RobbeElsermans/GestureControl/README.md

# Gesture Controlling 

Gesture controlling with X-NUCLEO-53L3A2 DevKit.

Developed by Robbe Elsermans With ED&A.

Info over de code is te vinden [hier](https://robbeelsermans.github.io/GestureControl/#/).
