RobbeElsermans/GestureControl/Final Project/Code/README.md

In deze folder **Code Final** zal je het finale projecten terug vinden. Hierin hebben we 2 versies.

* V1 is (deels) gegenereerd door ST. en gebruikt de HAL Drivers.
* V2 is er een abstractie laag (experimenteel) toegevoegd bovenop de HAL Drivers.

Beide versies werken.

beide versies zijn te compileren in PlatformIO. Hiervoor verwijs ik u graag naar de [documentatie](https://robbeelsermans.github.io/GestureControl/#/).
