RobbeElsermans/GestureControl/docs/_sidebar.md

- [Gesture Control](README.md#gesture-control)
- [Inhoudsopgaven](README.md#inhoudsopgaven)
- [Inleiding](README.md#inleiding)
- [Project Definitie](README.md#project-definitie)
- [Gebruikte Software](README.md#gebruikte-software)
- [Gebruikte Hardware](README.md#gebruikte-hardware)
- [Opbouw Project](README.md#opbouw-project)
  - [PinOut](README.md#pinout)
    - [Pin description](README.md#pin-description)
  - [genereer code](README.md#genereer-code)
  - [Importeer API VL53LXC](README.md#importeer-api-vl53lxc)
  - [importeren include & src bestanden](README.md#importeren-include--src-bestanden)
  - [Importeer Andere Bestanden](README.md#importeer-andere-bestanden)
  - [Installeer Platform & Board](README.md#installeer-platform--board)
  - [configureer platformio.ini file](README.md#configureer-platformioini-file)
  - [main.h & .c](README.md#mainh--c)
  - [Overzicht Bestanden](#overzicht-bestanden)
  - [Build & Upload](README.md#build--upload)
- [Hardware Opbouw](README.md#hardware-opbouw)
- [LED Controller](README.md#led-controller)
- [Bevindingen & Upgrades](README.md#bevindingen--upgrades)
- [Onderzoek](README.md#onderzoek)
  - [Plaats Sensoren Development Kit](README.md#plaats-sensoren-development-kit)
  - [Snelheid Metingen Development Kit](README.md#snelheid-metingen-development-kit)
    - [Eén sensor](README.md#eén-sensor)
      - [BLOCKING_CONTINUOUS](README.md#blocking_continuous)
      - [ASYNC_CONTINUOUS](README.md#async_continuous)
    - [Vijf sensoren](README.md#vijf-sensoren)
      - [BLOCKING_CONTINUOUS](README.md#blocking_continuous-1)
      - [ASYNC_CONTINUOUS](README.md#async_continuous-1)
  - [Plaats Sensoren PCBV0.3](README.md#plaats-sensoren-pcbv03)
    - [Kruislings](README.md#kruislings)
    - [Piramide](README.md#piramide)
    - [Trap](README.md#trap)
  - [Snelheid Metingen PCBV0.3](README.md#snelheid-metingen-pcbv03)
  - [Coverglas](README.md#coverglas)
    - [plexiplaat](README.md#plexiplaat)
    - [glasplaat](README.md#glasplaat)
  - [Smudge Detection plexiplaat](README.md#smudge-detection-plexiplaat)
    - [Normale werking](README.md#normale-werking)
    - [VL53LX_SMUDGE_CORRECTION_SINGLE](README.md#vl53lx_smudge_correction_single)
    - [VL53LX_SMUDGE_CORRECTION_CONTINUOUS](README.md#vl53lx_smudge_correction_continuous)
  - [Smudge Detection glasplaat](README.md#smudge-detection-glasplaat)
  - [Trap in software verwerkt](README.md#trap-in-software-verwerkt)
    - [Op papier](README.md#op-papier)
    - [Met Data](README.md#met-data)
  - [Bevindingen](README.md#bevindingen)
