RobbeElsermans/GestureControl/docs/_coverpage.md

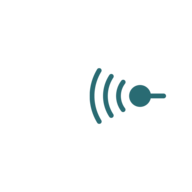
[picture p122: docs/FavoIcon/android-chrome-192x192.png]


# Gesture Control <small>1.0</small>

> A Gesture Controller interface for any application

- I<sup>2</sup>C supported
- Simple gestures
- Multiple enviroments

[GitHub](https://github.com/RobbeElsermans/GestureControl.git)
[Get Started](#Gesture-Control)

color
