RobbeElsermans/GestureControl/docs/foto's/Word foto editor.docx

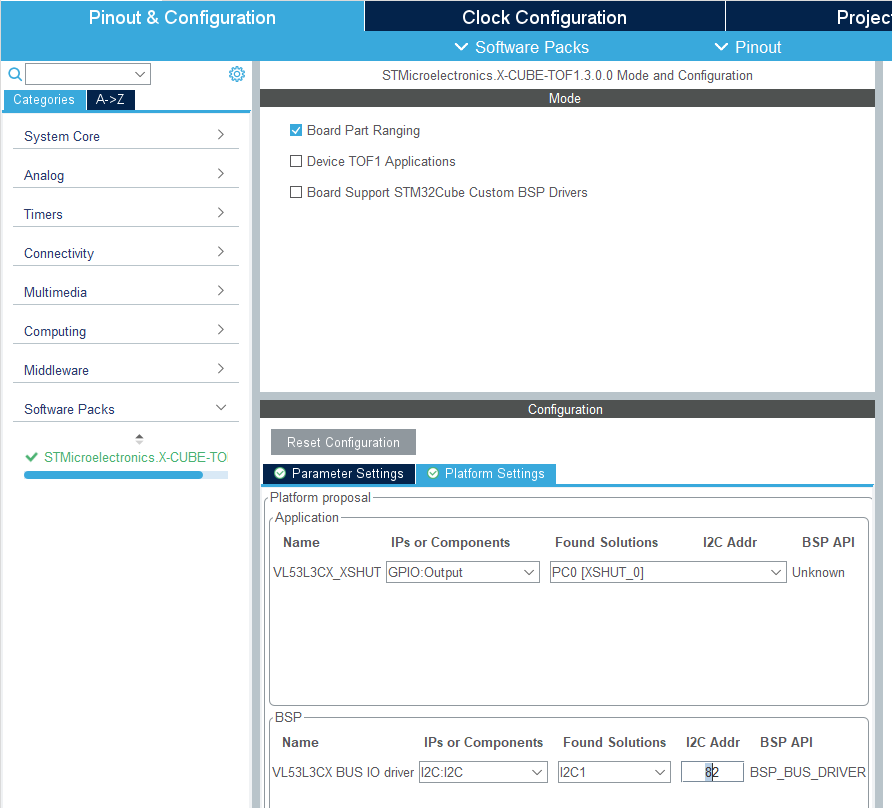
[picture p123: figure]
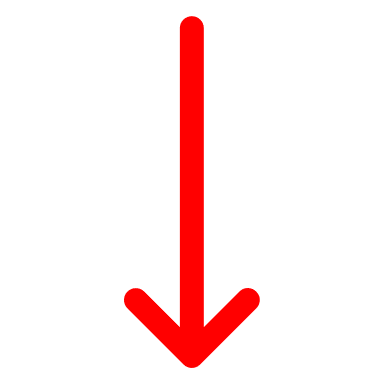
[picture p124: figure]
Pijl omhoog met effen opvulling

6

5

4

3

1

2

4
