RobbeElsermans/GestureControl/docs/foto's/DU_R_D_N_SNEL.png

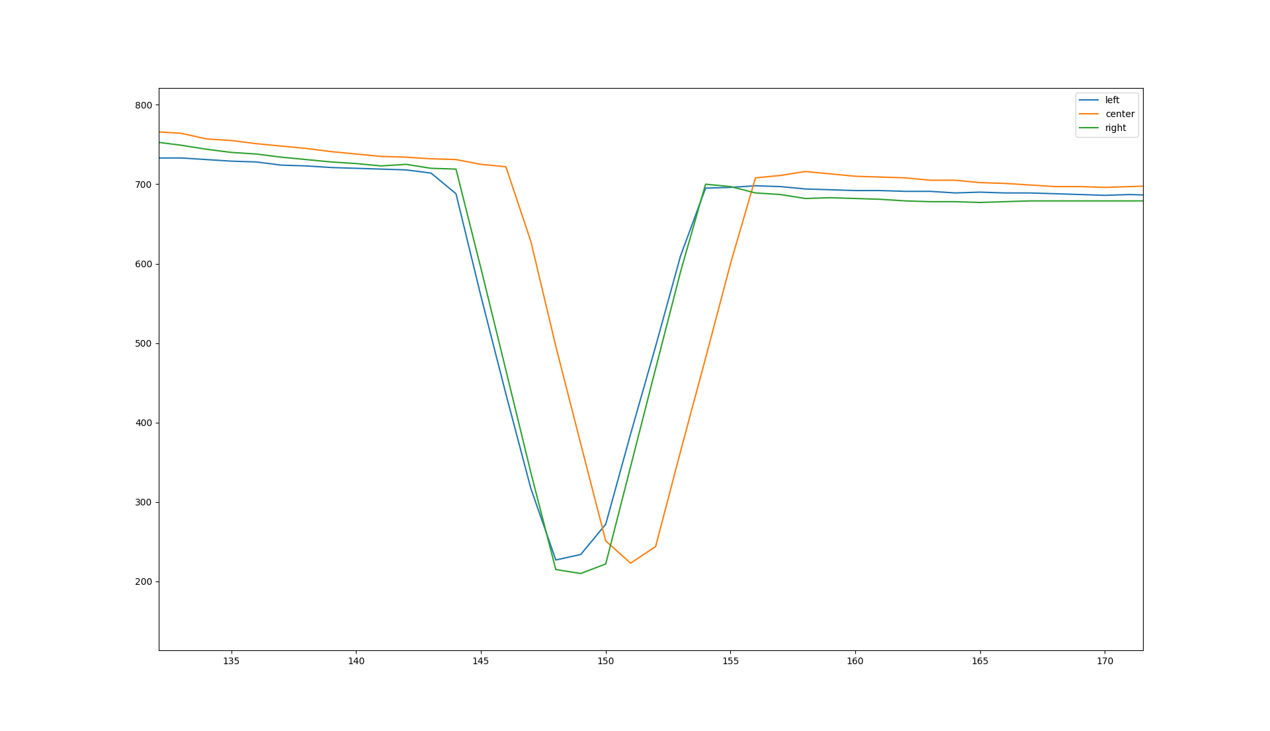
docs/foto's/DU_R_D_N_SNEL.png
