RobbeElsermans/GestureControl/docs/foto's/LR_R_D_N_SNEL.png

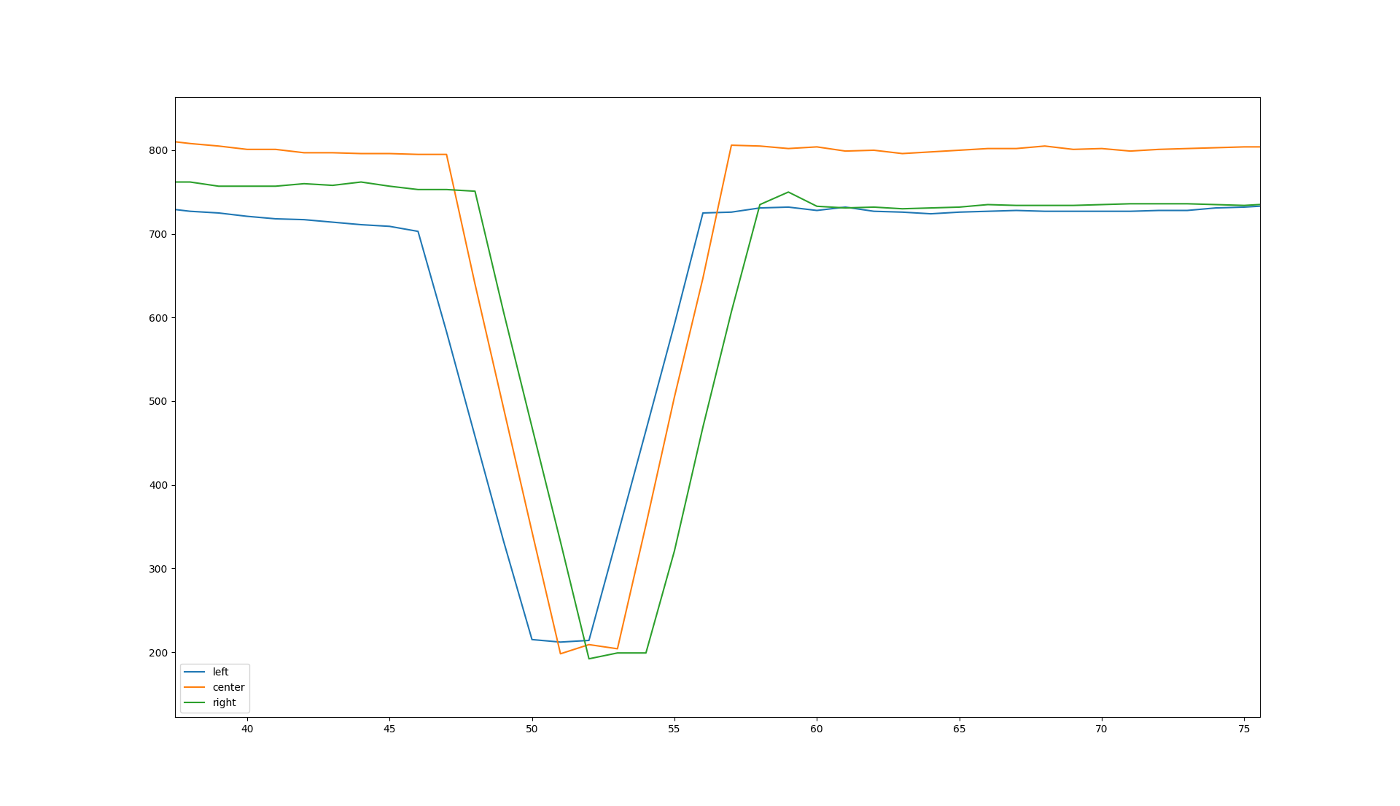
docs/foto's/LR_R_D_N_SNEL.png
