RobbeElsermans/GestureControl/docs/foto's/RL_R_D_N_SNEL.png

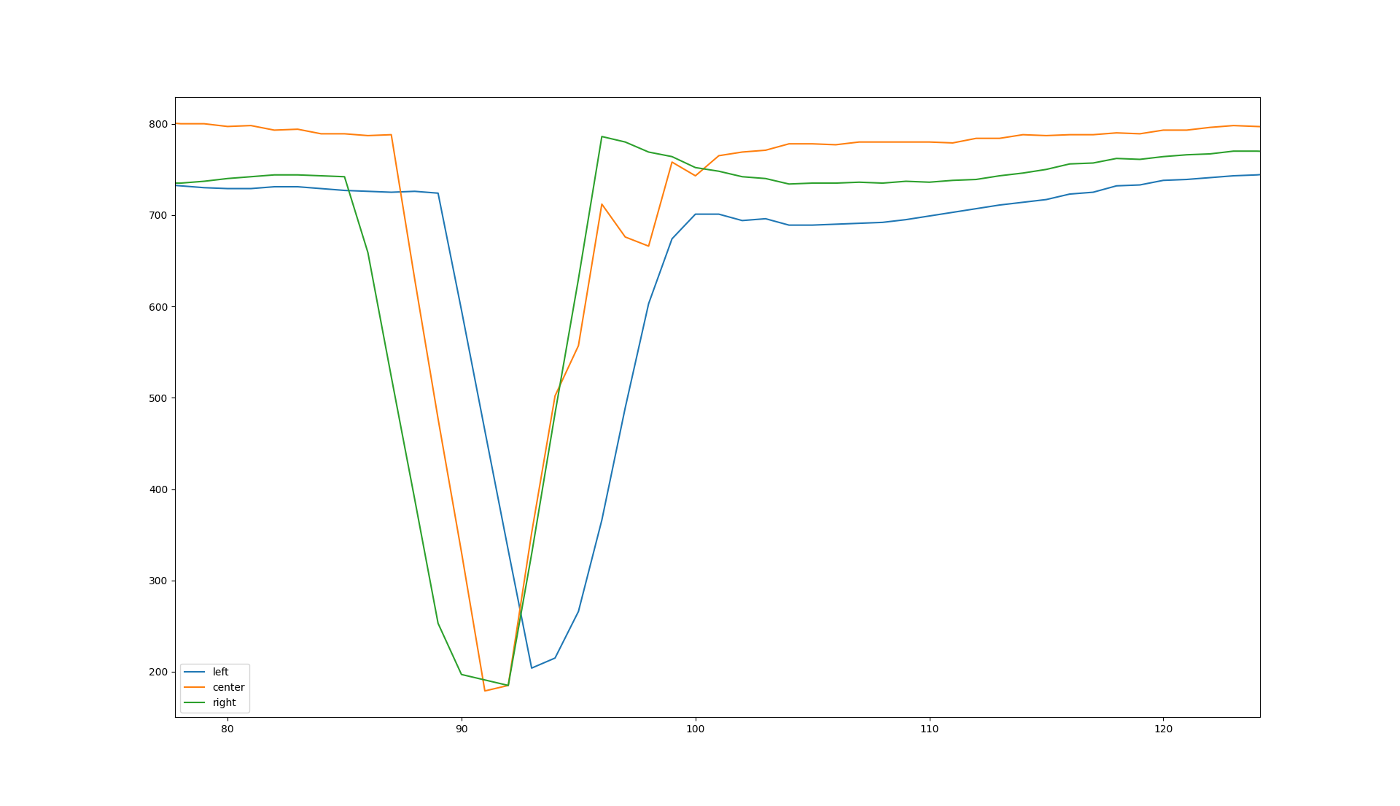
docs/foto's/RL_R_D_N_SNEL.png
