RobbeElsermans/GestureControl/docs/foto's/UD_R_D_N_SNEL.png

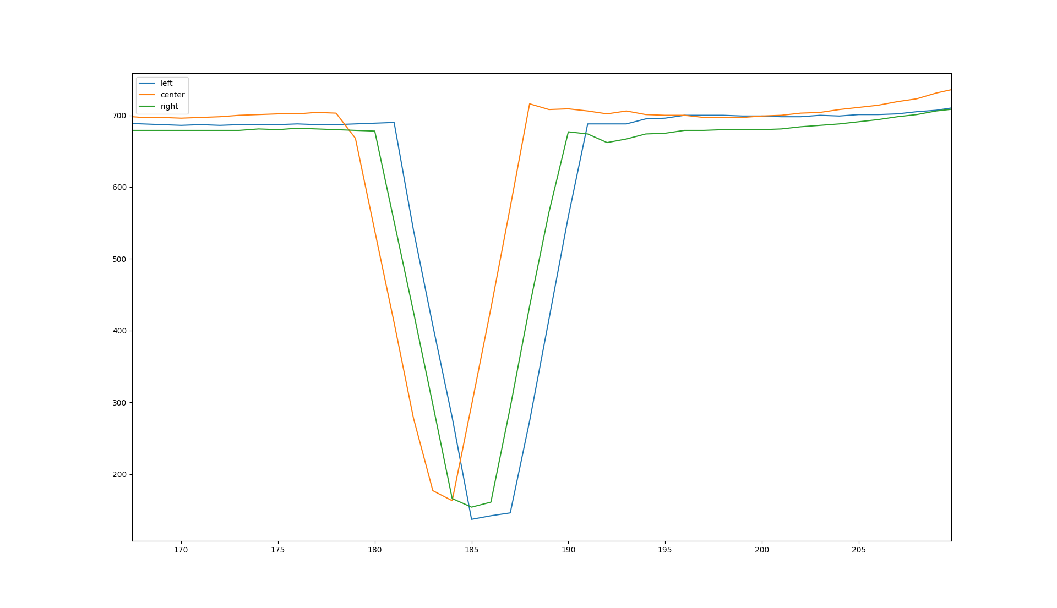
docs/foto's/UD_R_D_N_SNEL.png
