RobbeElsermans/GestureControl/docs/Hardware/PCB3D.png

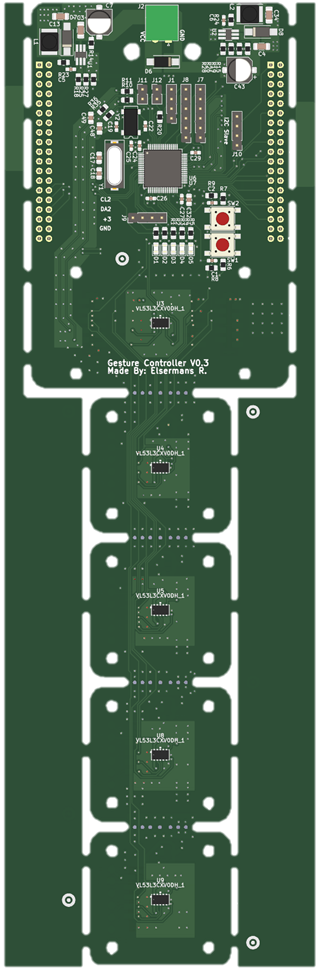
docs/Hardware/PCB3D.png
