RobbeElsermans/GestureControl/docs/Hardware/Schermafbeelding 2022-03-24 133611.jpg

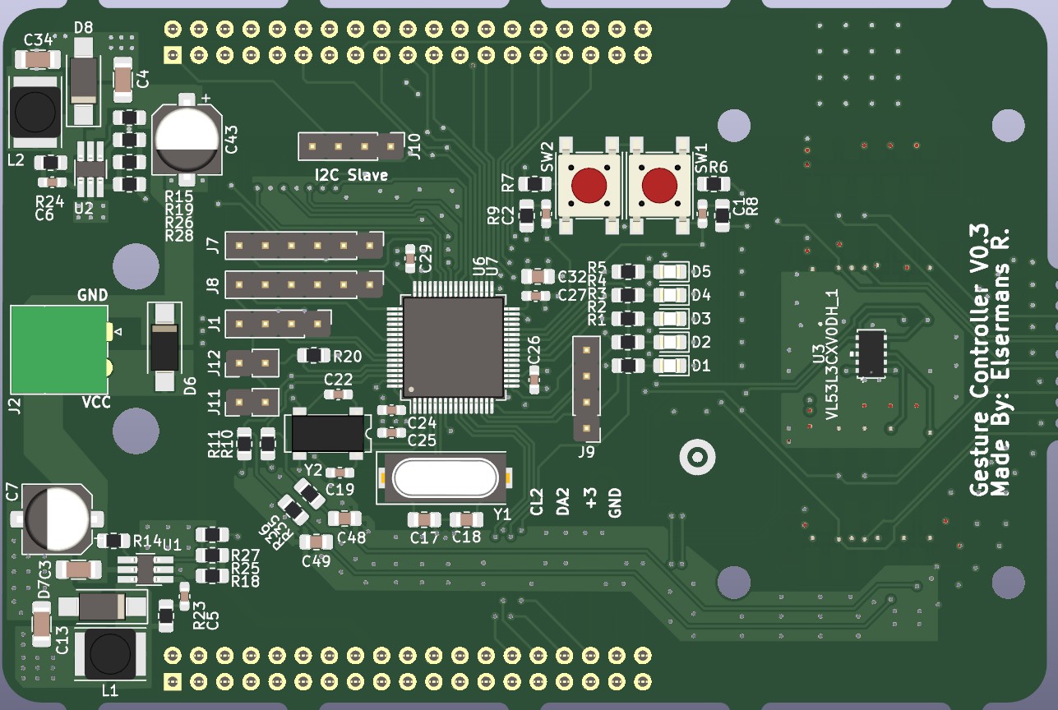
docs/Hardware/Schermafbeelding 2022-03-24 133611.jpg
