RobbeElsermans/GestureControl/Final Project/Code/Led Controller V2/plantuml/L1.png

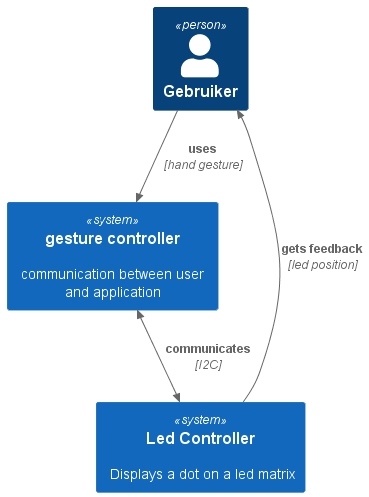
Final Project/Code/Led Controller V2/plantuml/L1.png
