RobbeElsermans/GestureControl/Final Project/Code/Led Controller V2/plantuml/L2.png

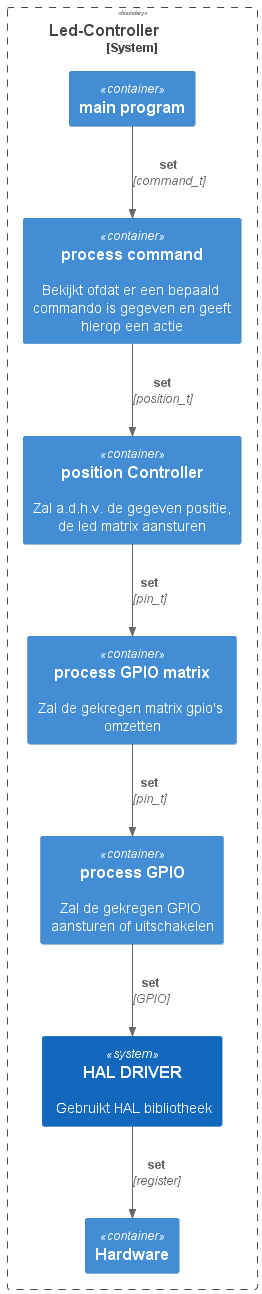
Final Project/Code/Led Controller V2/plantuml/L2.png
