RobbeElsermans/GestureControl/3D designs/breakoutboard/breakoutboard-main_holder.stl

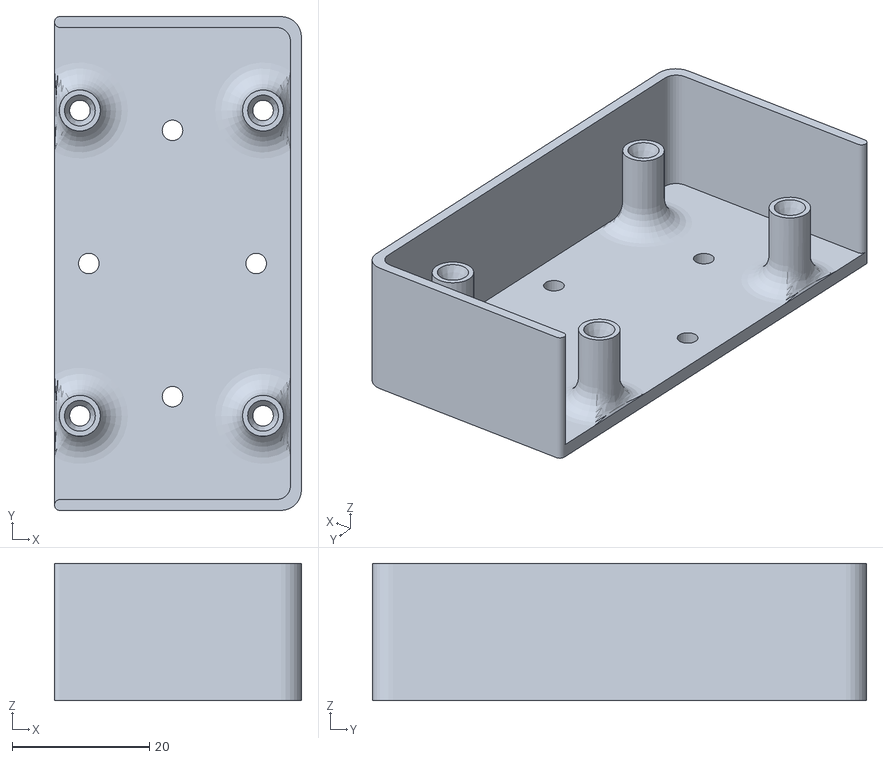
[picture p133: CAD file, 2022-03-29]
3D designs/breakoutboard/breakoutboard-main_holder.stl
36.0 x 72.0 x 20.0
