RobbeElsermans/GestureControl/3D designs/breakoutboard/PCBV0.3-Body.stl

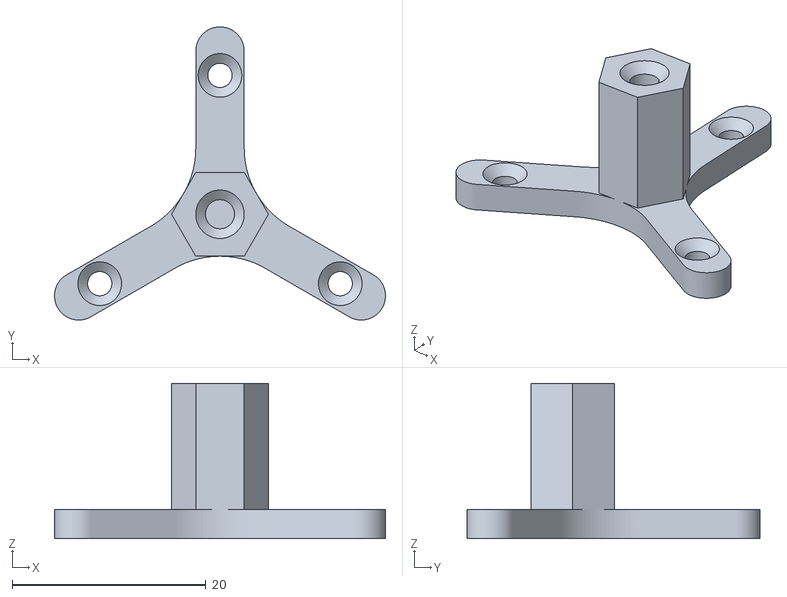
[picture p134: CAD file, 2022-04-15]
3D designs/breakoutboard/PCBV0.3-Body.stl
34.2 x 30.2 x 16.0
