RobbeElsermans/GestureControl/3D designs/Final opstelling/Gesture Controller-Body.3mf

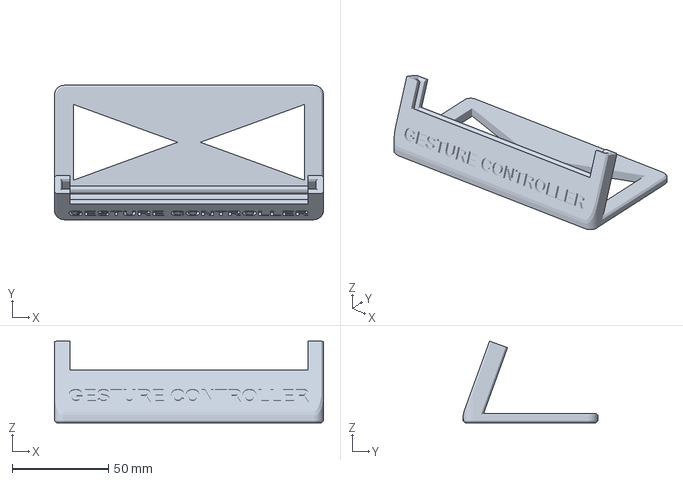
[picture p135: CAD file, 2022-05-14]
3D designs/Final opstelling/Gesture Controller-Body.3mf
140.0 x 70.0 x 42.6 mm
