RobbeElsermans/GestureControl/3D designs/Led Controller/nucleo striped.FCStd

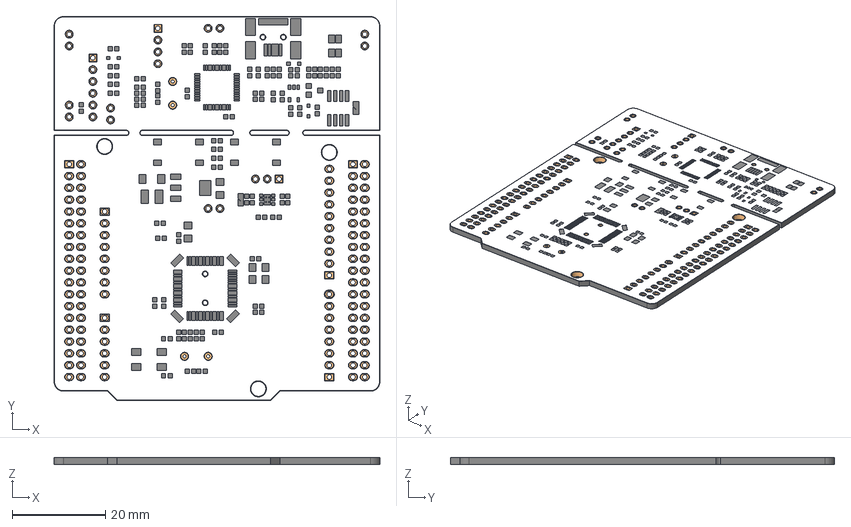
[picture p136: CAD file, 2022-05-14]
3D designs/Led Controller/nucleo striped.FCStd
70.0 x 82.5 x 1.58 mm
NUCLEO-F411RE_PCB_Varsaylan
NUCLEO-F411RE_PCB_HOLEs_Varsaylan
NUCLEO-F411RE_PCB_TOP_Solder_Varsaylan
NUCLEO-F411RE_PCB_BOTTOM_Pads_Varsaylan
NUCLEO-F411RE_PCB_BOTTOM_Solder_Varsaylan
