RobbeElsermans/GestureControl/3D designs/PCBV0.3/GlasPlates-Glasklever.step

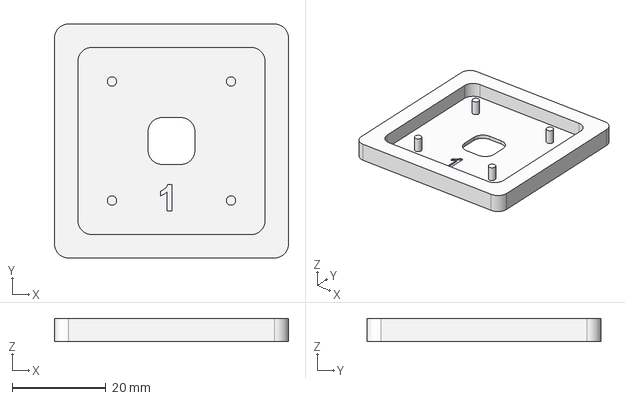
[picture p137: CAD file, 2022-05-10]
3D designs/PCBV0.3/GlasPlates-Glasklever.step
50.0 x 50.0 x 5.00 mm
