RobbeElsermans/GestureControl/Final Project/3D Design/Coverglas Gesture Controller/GlasPlates.FCStd

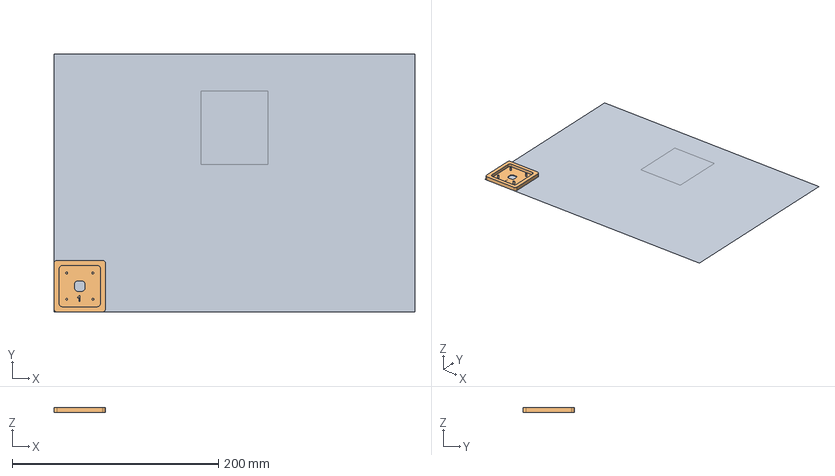
[picture p138: CAD file, 2022-05-24]
Final Project/3D Design/Coverglas Gesture Controller/GlasPlates.FCStd
350.0 x 250.0 x 5.00 mm
Block_SKETCH071
Glasklever
