RobbeElsermans/GestureControl/Final Project/3D Design/Stand Gesture Controller/Gesture Controller.FCStd

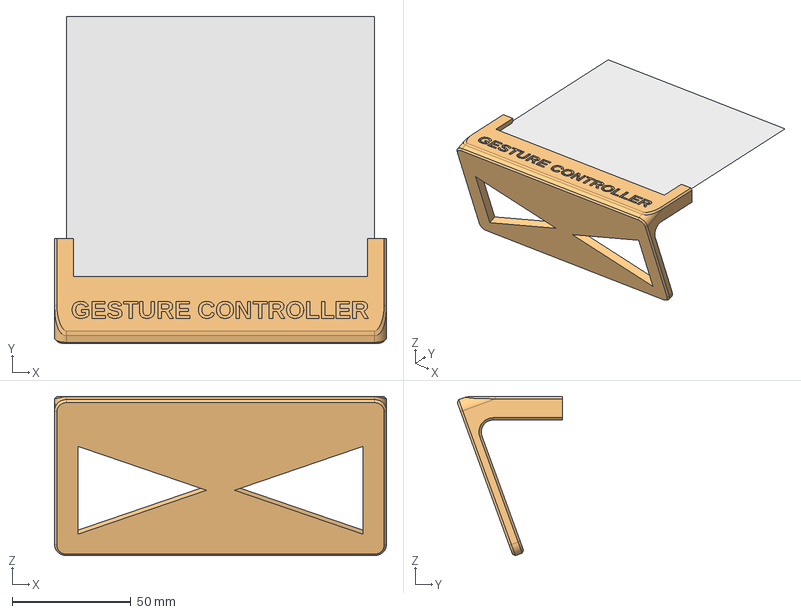
[picture p139: CAD file, 2022-05-14]
Final Project/3D Design/Stand Gesture Controller/Gesture Controller.FCStd
140.0 x 138.1 x 67.1 mm
Polyline
