RobbeElsermans/GestureControl/Final Project/3D Design/Stand Led Controller/Led Controller.FCStd

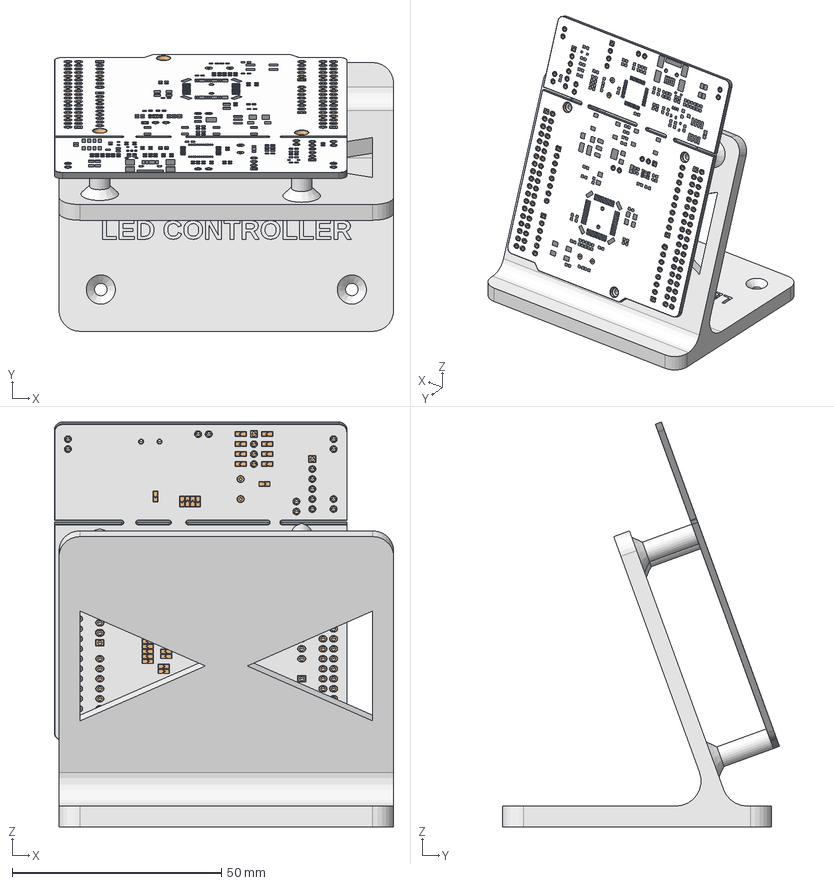
[picture p140: CAD file, 2022-05-14]
Final Project/3D Design/Stand Led Controller/Led Controller.FCStd
81.1 x 66.2 x 96.8 mm
NUCLEO-F411RE_PCB_Varsaylan
NUCLEO-F411RE_PCB_HOLEs_Varsaylan
NUCLEO-F411RE_PCB_TOP_Solder_Varsaylan
NUCLEO-F411RE_PCB_BOTTOM_Pads_Varsaylan
NUCLEO-F411RE_PCB_BOTTOM_Solder_Varsaylan
