RobbeElsermans/GestureControl/3D designs/breakoutboard/PCBV0.3-Body016.stl

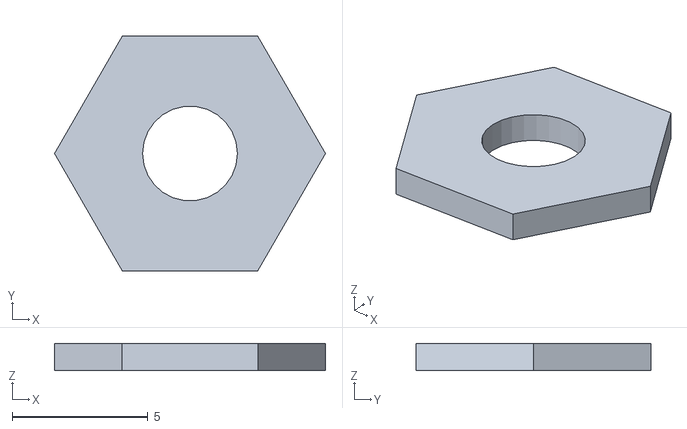
[picture p141: CAD file, 2022-04-15]
3D designs/breakoutboard/PCBV0.3-Body016.stl
10.0 x 8.66 x 1.00
