RobbeElsermans/GestureControl/3D designs/breakoutboard/PCBV0.3_CoverGlas.dxf

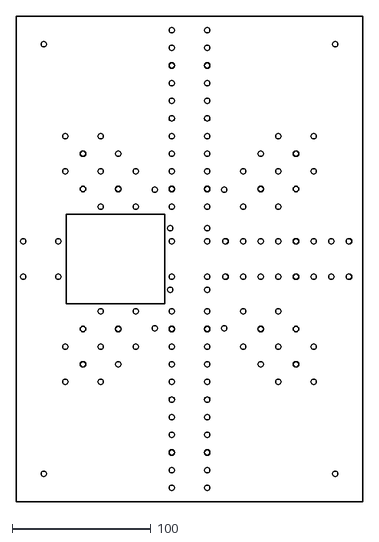
[picture p142: CAD file, 2022-04-15]
3D designs/breakoutboard/PCBV0.3_CoverGlas.dxf
250.0 x 350.0
