RobbeElsermans/GestureControl/3D designs/PCBV0.3/GlasPlates-Glasklever_1.4.stl

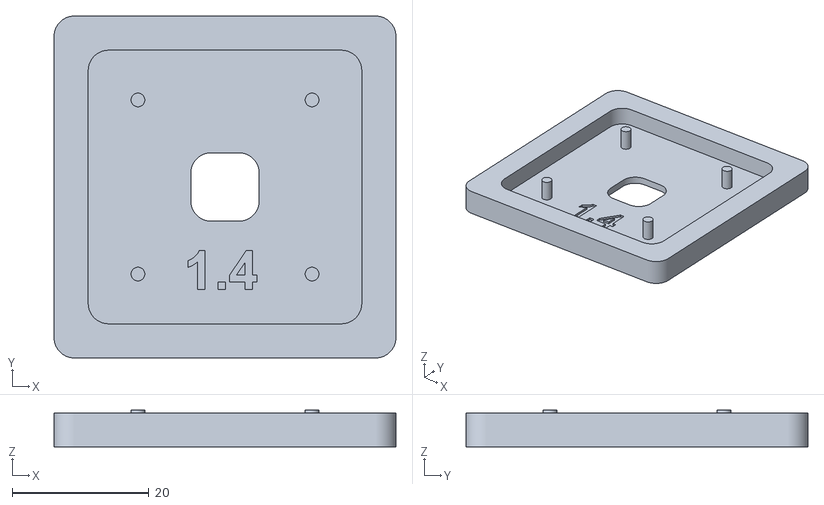
[picture p143: CAD file, 2022-05-09]
3D designs/PCBV0.3/GlasPlates-Glasklever_1.4.stl
50.0 x 50.0 x 5.40
