RobbeElsermans/GestureControl/3D designs/breakoutboard/PCBV0.3-Body017.stl

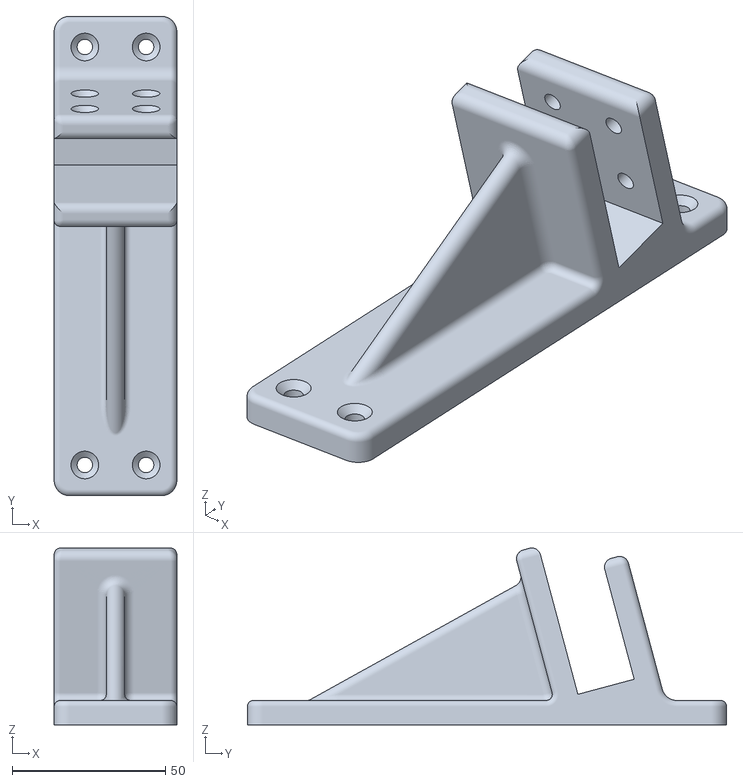
[picture p144: CAD file, 2022-04-15]
3D designs/breakoutboard/PCBV0.3-Body017.stl
40.0 x 156.2 x 57.7
