RobbeElsermans/GestureControl/3D designs/PCBV0.3/GlasPlates-Trap.dxf

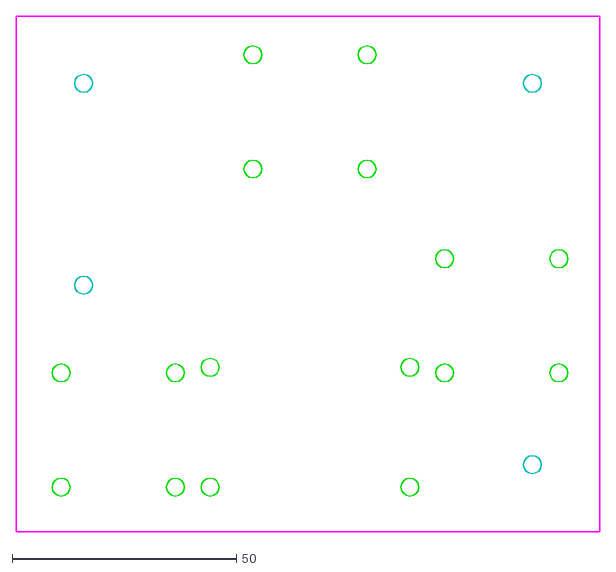
[picture p145: CAD file, 2022-04-28]
3D designs/PCBV0.3/GlasPlates-Trap.dxf
130.0 x 115.0
