RobbeElsermans/GestureControl/3D designs/breakoutboard/PCBV0.3-Body015.stl

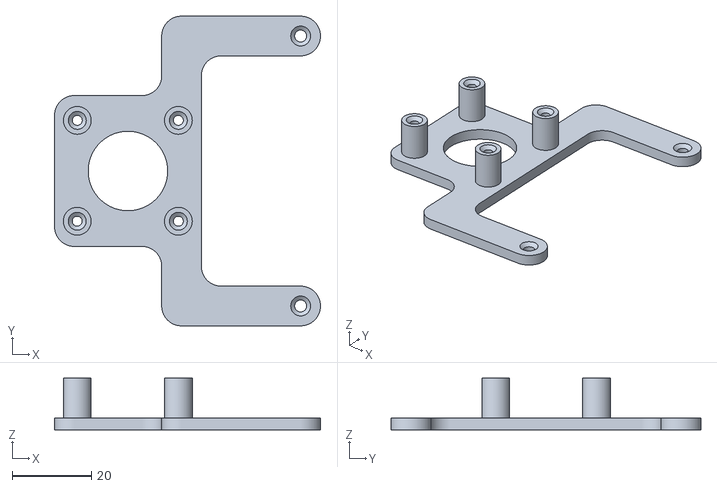
[picture p146: CAD file, 2022-04-14]
3D designs/breakoutboard/PCBV0.3-Body015.stl
67.0 x 78.0 x 13.0
