RobbeElsermans/GestureControl/3D designs/PCBV0.3/GlasPlates-Trap_original.dxf

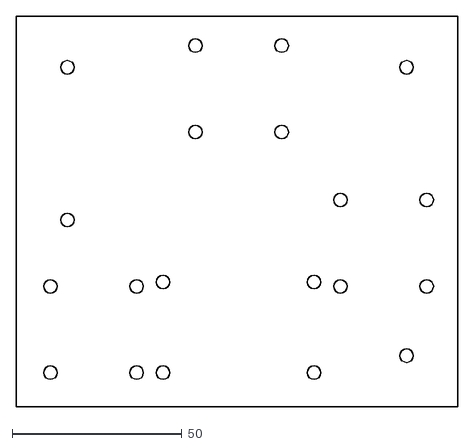
[picture p147: CAD file, 2022-04-28]
3D designs/PCBV0.3/GlasPlates-Trap_original.dxf
130.0 x 115.0
