RobbeElsermans/GestureControl/3D designs/breakoutboard/breakoutboard-Body013.stl

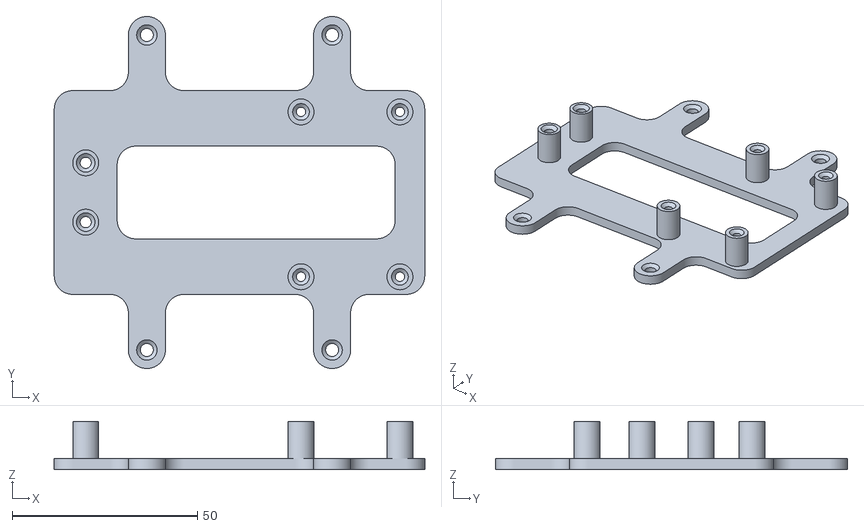
[picture p148: CAD file, 2022-04-12]
3D designs/breakoutboard/breakoutboard-Body013.stl
100.0 x 95.0 x 13.0
