RobbeElsermans/GestureControl/3D designs/PCBV0.3/#GlasPlates-BodySketch.dxf

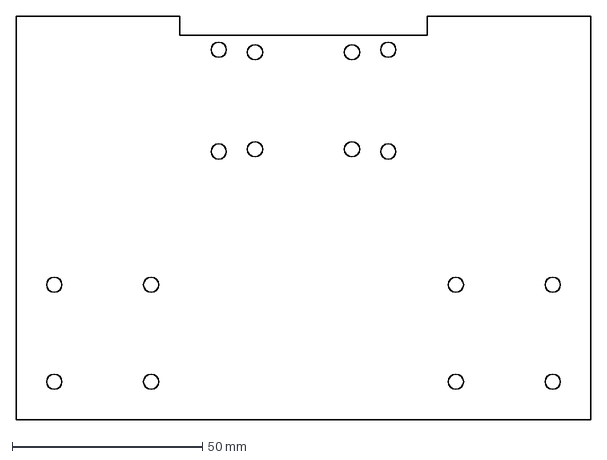
[picture p149: CAD file, 2022-04-25]
3D designs/PCBV0.3/#GlasPlates-BodySketch.dxf
150.9 x 106.0 mm
