RobbeElsermans/GestureControl/3D designs/breakoutboard/breakoutboard-Body014.stl

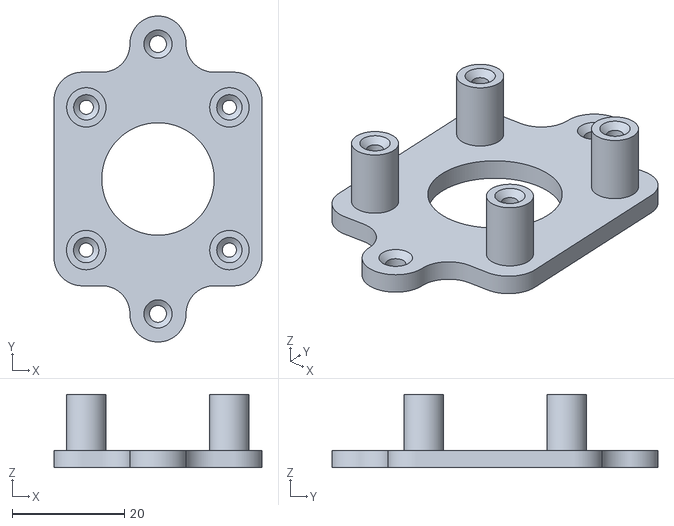
[picture p150: CAD file, 2022-04-12]
3D designs/breakoutboard/breakoutboard-Body014.stl
37.0 x 58.0 x 13.0
