RobbeElsermans/GestureControl/3D designs/breakoutboard/breakoutboard-sensor_bak001.stl

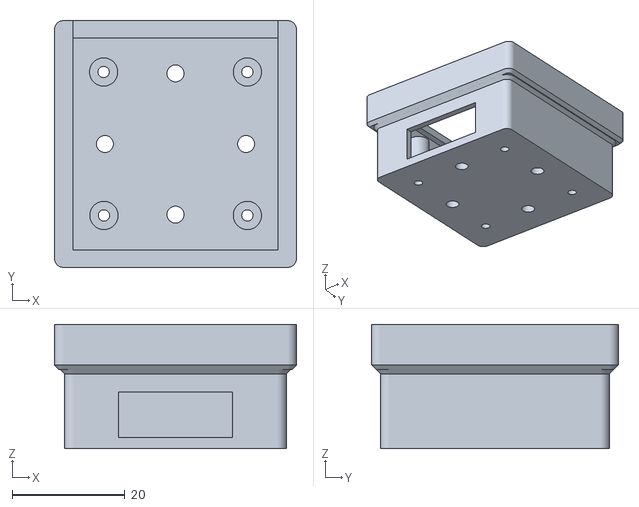
[picture p151: CAD file, 2022-03-29]
3D designs/breakoutboard/breakoutboard-sensor_bak001.stl
42.9 x 43.7 x 22.0
