RobbeElsermans/GestureControl/3D designs/breakoutboard/breakoutboard-sensor_bak.stl

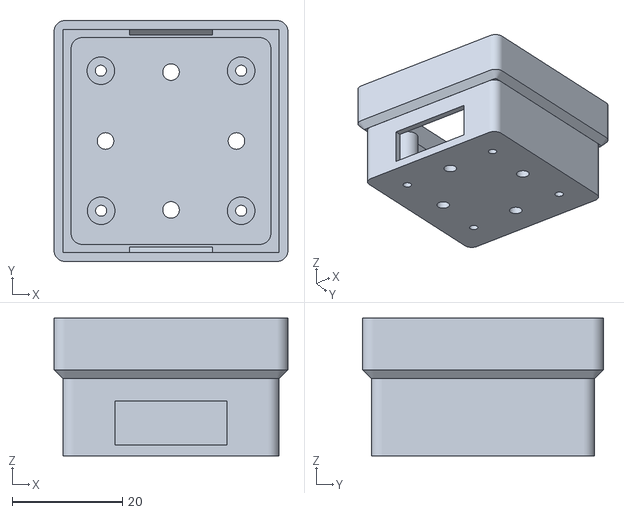
[picture p152: CAD file, 2022-03-29]
3D designs/breakoutboard/breakoutboard-sensor_bak.stl
42.5 x 43.7 x 25.0
