RobbeElsermans/GestureControl/3D designs/breakoutboard/breakoutboard-bottom.step

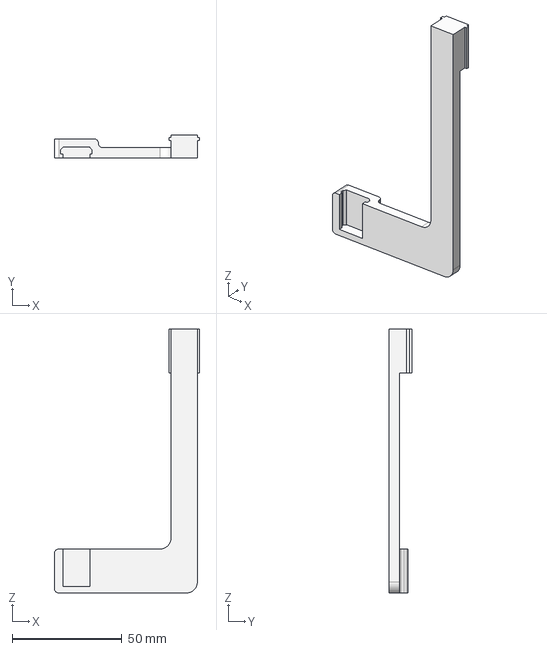
[picture p153: CAD file, 2022-03-25]
3D designs/breakoutboard/breakoutboard-bottom.step
66.0 x 10.6 x 120.0 mm
