RobbeElsermans/GestureControl/3D designs/breakoutboard/breakoutboard-top.step

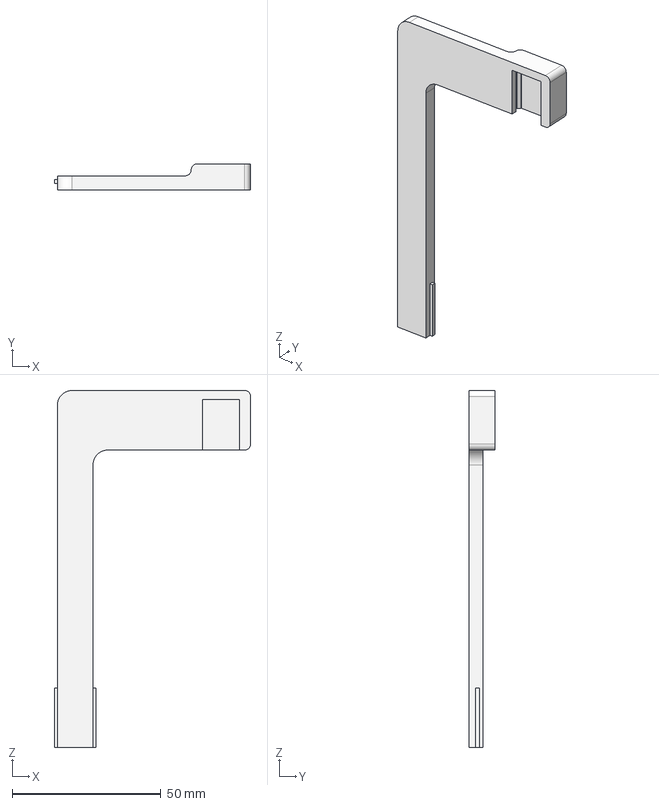
[picture p154: CAD file, 2022-03-25]
3D designs/breakoutboard/breakoutboard-top.step
66.0 x 8.80 x 120.0 mm
