RobbeElsermans/GestureControl/3D designs/breakoutboard/breakoutboard-holderV2.step

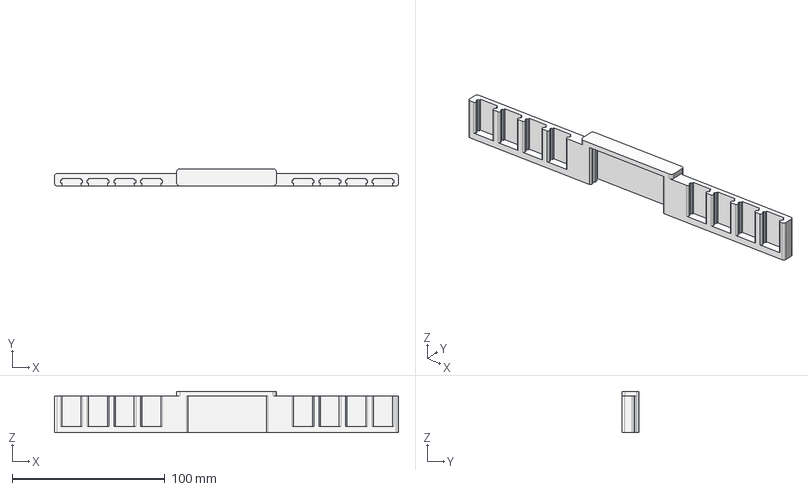
[picture p155: CAD file, 2022-03-25]
3D designs/breakoutboard/breakoutboard-holderV2.step
225.2 x 11.0 x 27.0 mm
