RobbeElsermans/GestureControl/3D designs/breakoutboard/breakoutboard.FCStd

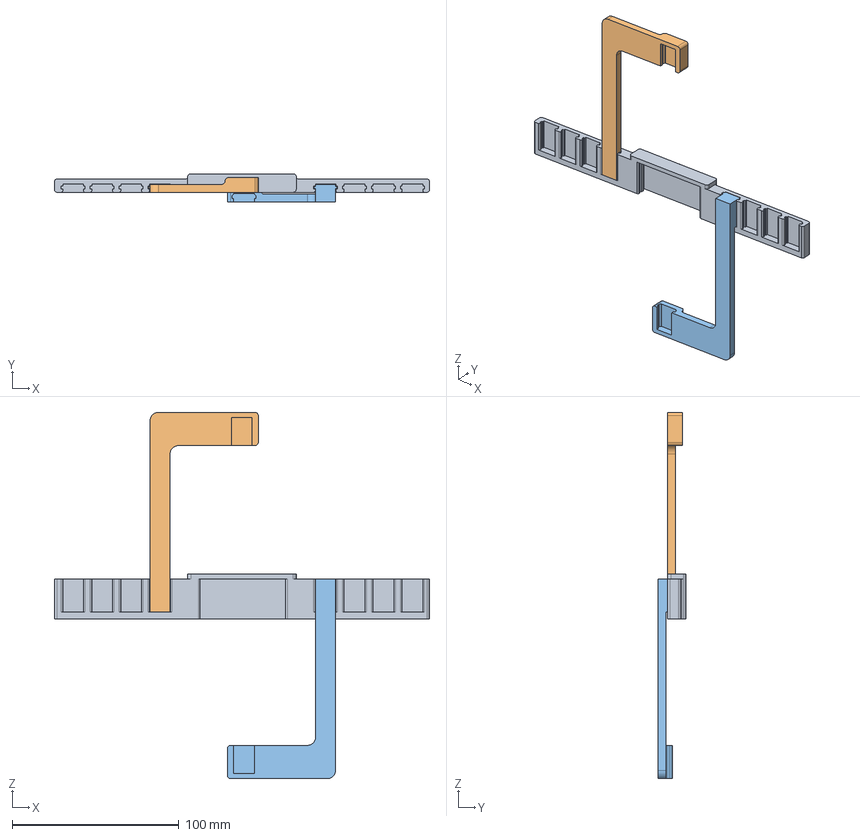
[picture p156: CAD file, 2022-03-14]
3D designs/breakoutboard/breakoutboard.FCStd
225.2 x 16.8 x 220.0 mm
HolderV2
Holder_Top
Holder_Botton
