RobbeElsermans/GestureControl/(list of files, cad)

Other CAD files:
3D designs/Led Controller/Led Controller-Body.3mf
3D designs/PCBV0.3/GlasPlates.FCStd
3D designs/PCBV0.3/GlasPlates-Glasklever_1.stl
3D designs/breakoutboard/PCBV0.3.FCStd
3D designs/breakoutboard/breakoutboard-Holder_Top.stl
3D designs/breakoutboard/breakoutboard-Holder_Botton.stl
3D designs/PCBV0.3/GlasPlates-BodySketch.dxf
3D designs/PCBV0.3/GlasPlates-Glasklever.dxf
3D designs/breakoutboard/PCBV0.3.dxf
3D designs/breakoutboard/breakoutboard-holderV1.stl
3D designs/breakoutboard/breakoutboard-holderV2.stl
3D designs/breakoutboard/breakoutboard.stl
