RobbeElsermans/GestureControl/Code PlatformIO/Gesture Control PCBV0.3_F302RET6/python/test/data_2022-05-10_111240.csv

DISTANCE | STATUS
820 | 0
816 | 0
820 | 0
816 | 0
819 | 0
817 | 0
816 | 0
817 | 0
819 | 0
820 | 0
819 | 0
819 | 0
817 | 0
817 | 0
815 | 0
815 | 0
817 | 0
816 | 0
818 | 0
816 | 0
815 | 0
815 | 0
817 | 0
817 | 0
820 | 0
817 | 0
819 | 0
819 | 0
814 | 0
823 | 0
817 | 0
822 | 0
821 | 0
821 | 0
819 | 0
821 | 0
818 | 0
821 | 0
819 | 0
824 | 0
820 | 0
821 | 0
818 | 0
823 | 0
818 | 0
827 | 0
815 | 0
826 | 0
815 | 0
828 | 0
815 | 0
825 | 0
818 | 0
824 | 0
821 | 0
820 | 0
819 | 0
816 | 0
817 | 0
813 | 0
819 | 0
811 | 0
821 | 0
812 | 0
821 | 0
810 | 0
819 | 0
815 | 0
817 | 0
819 | 0
823 | 0
819 | 0
822 | 0
821 | 0
820 | 0
821 | 0
819 | 0
825 | 0
820 | 0
821 | 0
820 | 0
817 | 0
817 | 0
821 | 0
818 | 0
819 | 0
819 | 0
819 | 0
819 | 0
817 | 0
816 | 0
814 | 0
817 | 0
818 | 0
817 | 0
816 | 0
818 | 0
819 | 0
821 | 0
819 | 0
819 | 0
821 | 0
823 | 0
824 | 0
824 | 0
820 | 0
827 | 0
822 | 0
823 | 0
821 | 0
822 | 0
820 | 0
820 | 0
819 | 0
819 | 0
818 | 0
819 | 0
819 | 0
816 | 0
818 | 0
818 | 0
816 | 0
816 | 0
812 | 0
817 | 0
810 | 0
817 | 0
808 | 0
816 | 0
808 | 0
816 | 0
809 | 0
816 | 0
811 | 0
817 | 0
815 | 0
818 | 0
815 | 0
819 | 0
816 | 0
820 | 0
815 | 0
820 | 0
811 | 0
820 | 0
812 | 0
819 | 0
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
