RobbeElsermans/GestureControl/Code PlatformIO/Gesture Control PCBV0.3_F302RET6/python/test/data_2022-05-10_112824.csv

DISTANCE | STATUS
1140 | 0
1152 | 0
1140 | 0
1150 | 0
1137 | 0
1150 | 0
1139 | 0
1146 | 0
1141 | 0
1152 | 0
1142 | 0
1145 | 0
1149 | 0
1149 | 0
1154 | 0
1150 | 0
1151 | 0
1150 | 0
1149 | 0
1152 | 0
1149 | 0
1148 | 0
1152 | 0
1146 | 0
1149 | 0
1139 | 0
1149 | 0
1148 | 0
1152 | 0
1143 | 0
1152 | 0
1142 | 0
1150 | 0
1140 | 0
1151 | 0
1140 | 0
1153 | 0
1140 | 0
1150 | 0
1135 | 0
1151 | 0
1139 | 0
1152 | 0
1141 | 0
1147 | 0
1143 | 0
1146 | 0
1142 | 0
1145 | 0
1145 | 0
1152 | 0
1142 | 0
1148 | 0
1142 | 0
1147 | 0
1139 | 0
1155 | 0
1140 | 0
1158 | 0
1141 | 0
1156 | 0
1145 | 0
1143 | 0
1152 | 0
1151 | 0
1160 | 0
1154 | 0
1165 | 0
1150 | 0
1159 | 0
1145 | 0
1162 | 0
1148 | 0
1149 | 0
1154 | 0
1140 | 0
1153 | 0
1133 | 0
1148 | 0
1129 | 0
1147 | 0
1132 | 0
1150 | 0
1135 | 0
1144 | 0
1139 | 0
1142 | 0
1142 | 0
1137 | 0
1145 | 0
1142 | 0
1149 | 0
1147 | 0
1149 | 0
1145 | 0
1142 | 0
1144 | 0
1148 | 0
1150 | 0
1148 | 0
1152 | 0
1152 | 0
1154 | 0
1149 | 0
1152 | 0
1149 | 0
1156 | 0
1157 | 0
1161 | 0
1152 | 0
1155 | 0
1154 | 0
1157 | 0
1155 | 0
1154 | 0
1149 | 0
1157 | 0
1151 | 0
1156 | 0
1149 | 0
1156 | 0
1146 | 0
1165 | 0
1143 | 0
1163 | 0
1140 | 0
1152 | 0
1146 | 0
1147 | 0
1147 | 0
1139 | 0
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
