RobbeElsermans/GestureControl/Code PlatformIO/Gesture Control PCBV0.3_F302RET6/python/test/data_2022-05-10_113120.csv

DISTANCE | STATUS
1157 | 0
1164 | 0
1156 | 0
1164 | 0
1156 | 0
1161 | 0
1157 | 0
1162 | 0
1159 | 0
1159 | 0
1165 | 0
1162 | 0
1172 | 0
1165 | 0
1170 | 0
1163 | 0
1172 | 0
1160 | 0
1168 | 0
1163 | 0
1169 | 0
1168 | 0
1169 | 0
1166 | 0
1160 | 0
1166 | 0
1166 | 0
1167 | 0
1167 | 0
1173 | 0
1171 | 0
1170 | 0
1173 | 0
1185 | 0
1176 | 0
1173 | 0
1183 | 0
1172 | 0
1179 | 0
1181 | 0
1175 | 0
1180 | 0
1176 | 0
1172 | 0
1174 | 0
1168 | 0
1175 | 0
1168 | 0
1174 | 0
1167 | 0
1175 | 0
1168 | 0
1176 | 0
1169 | 0
1176 | 0
1171 | 0
1174 | 0
1187 | 0
1167 | 0
1187 | 0
1167 | 0
1198 | 0
1165 | 0
1174 | 0
1166 | 0
1195 | 0
1166 | 0
1176 | 0
1167 | 0
1174 | 0
1172 | 0
1175 | 0
1168 | 0
1174 | 0
1169 | 0
1174 | 0
1173 | 0
1177 | 0
1174 | 0
1175 | 0
1172 | 0
1172 | 0
1172 | 0
1173 | 0
1179 | 0
1172 | 0
1177 | 0
1172 | 0
1175 | 0
1168 | 0
1171 | 0
1167 | 0
1171 | 0
1168 | 0
1167 | 0
1168 | 0
1165 | 0
1163 | 0
1164 | 0
1161 | 0
1157 | 0
1160 | 0
1155 | 0
1178 | 0
1157 | 0
1166 | 0
1161 | 0
1167 | 0
1154 | 0
1185 | 0
1157 | 0
1189 | 0
1163 | 0
1173 | 0
1166 | 0
1169 | 0
1168 | 0
1170 | 0
1171 | 0
1164 | 0
1174 | 0
1168 | 0
1176 | 0
1169 | 0
1172 | 0
1169 | 0
1171 | 0
1172 | 0
1174 | 0
1171 | 0
1170 | 0
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
