RobbeElsermans/GestureControl/Code PlatformIO/Gesture Control PCBV0.3_F302RET6/python/test/data_2022-05-10_11490.csv

DISTANCE | STATUS
860 | 0
850 | 0
852 | 0
851 | 0
852 | 0
847 | 0
850 | 0
849 | 0
851 | 0
850 | 0
851 | 0
850 | 0
848 | 0
850 | 0
848 | 0
847 | 0
849 | 0
852 | 0
849 | 0
855 | 0
851 | 0
852 | 0
851 | 0
849 | 0
851 | 0
852 | 0
853 | 0
852 | 0
852 | 0
851 | 0
854 | 0
848 | 0
852 | 0
851 | 0
853 | 0
851 | 0
854 | 0
848 | 0
855 | 0
849 | 0
856 | 0
845 | 0
854 | 0
845 | 0
855 | 0
845 | 0
855 | 0
848 | 0
854 | 0
851 | 0
851 | 0
851 | 0
850 | 0
853 | 0
854 | 0
855 | 0
856 | 0
856 | 0
854 | 0
856 | 0
854 | 0
853 | 0
859 | 0
853 | 0
856 | 0
853 | 0
853 | 0
851 | 0
851 | 0
849 | 0
851 | 0
847 | 0
854 | 0
850 | 0
852 | 0
850 | 0
854 | 0
859 | 0
855 | 0
871 | 0
856 | 0
863 | 0
861 | 0
876 | 0
860 | 0
852 | 0
860 | 0
853 | 0
855 | 0
853 | 0
857 | 0
851 | 0
851 | 0
848 | 0
848 | 0
845 | 0
847 | 0
846 | 0
848 | 0
846 | 0
853 | 0
846 | 0
850 | 0
847 | 0
854 | 0
847 | 0
849 | 0
850 | 0
848 | 0
849 | 0
853 | 0
851 | 0
851 | 0
850 | 0
850 | 0
851 | 0
849 | 0
854 | 0
850 | 0
852 | 0
852 | 0
853 | 0
846 | 0
855 | 0
851 | 0
851 | 0
851 | 0
851 | 0
851 | 0
862 | 0
852 | 0
862 | 0
853 | 0
853 | 0
856 | 0
853 | 0
849 | 0
859 | 0
851 | 0
858 | 0
850 | 0
858 | 0
853 | 0
858 | 0
850 | 0
856 | 0
848 | 0
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
