RobbeElsermans/GestureControl/Code PlatformIO/Gesture Control PCBV0.3_F302RET6/python/test/data_2022-05-10_115625.csv

DISTANCE | STATUS
1287 | 0
1270 | 0
1283 | 0
1265 | 0
1280 | 0
1263 | 0
1275 | 0
1260 | 0
1274 | 0
1263 | 0
1282 | 0
1263 | 0
1283 | 0
1260 | 0
1277 | 0
1265 | 0
1275 | 0
1266 | 0
1277 | 0
1265 | 0
1276 | 0
1271 | 0
1271 | 0
1268 | 0
1266 | 0
1270 | 0
1269 | 0
1270 | 0
1261 | 0
1269 | 0
1254 | 0
1270 | 0
1267 | 0
1264 | 0
1268 | 0
1269 | 0
1267 | 0
1268 | 0
1269 | 0
1265 | 0
1275 | 0
1263 | 0
1279 | 0
1263 | 0
1268 | 0
1257 | 0
1265 | 0
1260 | 0
1274 | 0
1257 | 0
1268 | 0
1255 | 0
1269 | 0
1261 | 0
1263 | 0
1267 | 0
1266 | 0
1268 | 0
1267 | 0
1266 | 0
1261 | 0
1265 | 0
1259 | 0
1263 | 0
1259 | 0
1264 | 0
1270 | 0
1260 | 0
1267 | 0
1259 | 0
1270 | 0
1256 | 0
1274 | 0
1264 | 0
1268 | 0
1266 | 0
1270 | 0
1260 | 0
1259 | 0
1258 | 0
1265 | 0
1254 | 0
1270 | 0
1254 | 0
1258 | 0
1249 | 0
1264 | 0
1248 | 0
1260 | 0
1252 | 0
1269 | 0
1250 | 0
1266 | 0
1259 | 0
1274 | 0
1268 | 0
1280 | 0
1275 | 0
1281 | 0
1279 | 0
1289 | 0
1275 | 0
1281 | 0
1276 | 0
1280 | 0
1266 | 0
1274 | 0
1258 | 0
1271 | 0
1257 | 0
1265 | 0
1252 | 0
1255 | 0
1257 | 0
1254 | 0
1256 | 0
1244 | 0
1262 | 0
1245 | 0
1266 | 0
1250 | 0
1257 | 0
1260 | 0
1258 | 0
1257 | 0
1256 | 0
1262 | 0
1264 | 0
1266 | 0
1261 | 0
1267 | 0
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
