RobbeElsermans/GestureControl/Code PlatformIO/Gesture Control PCBV0.3_F302RET6/python/test/data_2022-05-10_11952.csv

DISTANCE | STATUS
826 | 0
824 | 0
824 | 0
827 | 0
826 | 0
827 | 0
827 | 0
828 | 0
826 | 0
831 | 0
836 | 0
829 | 0
854 | 0
827 | 0
856 | 0
824 | 0
854 | 0
827 | 0
827 | 0
825 | 0
850 | 0
821 | 0
851 | 0
822 | 0
851 | 0
825 | 0
832 | 0
827 | 0
832 | 0
824 | 0
830 | 0
827 | 0
836 | 0
830 | 0
835 | 0
831 | 0
826 | 0
827 | 0
834 | 0
827 | 0
849 | 0
827 | 0
850 | 0
827 | 0
846 | 0
826 | 0
819 | 0
827 | 0
839 | 0
832 | 0
841 | 0
832 | 0
843 | 0
833 | 0
840 | 0
833 | 0
841 | 0
831 | 0
843 | 0
830 | 0
840 | 0
827 | 0
836 | 0
827 | 0
844 | 0
826 | 0
819 | 0
826 | 0
847 | 0
827 | 0
845 | 0
827 | 0
829 | 0
830 | 0
831 | 0
828 | 0
831 | 0
828 | 0
835 | 0
829 | 0
835 | 0
829 | 0
835 | 0
830 | 0
834 | 0
828 | 0
835 | 0
829 | 0
834 | 0
831 | 0
831 | 0
830 | 0
826 | 0
830 | 0
855 | 0
829 | 0
859 | 0
831 | 0
859 | 0
831 | 0
857 | 0
829 | 0
859 | 0
827 | 0
840 | 0
828 | 0
837 | 0
829 | 0
834 | 0
823 | 0
835 | 0
824 | 0
836 | 0
826 | 0
838 | 0
829 | 0
861 | 0
829 | 0
859 | 0
829 | 0
841 | 0
830 | 0
860 | 0
827 | 0
861 | 0
825 | 0
857 | 0
823 | 0
833 | 0
825 | 0
835 | 0
825 | 0
835 | 0
824 | 0
833 | 0
827 | 0
834 | 0
828 | 0
833 | 0
827 | 0
833 | 0
822 | 0
829 | 0
823 | 0
829 | 0
828 | 0
831 | 0
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
