RobbeElsermans/GestureControl/Final Project/Code/Gesture Control Final V2/plantuml/test.png

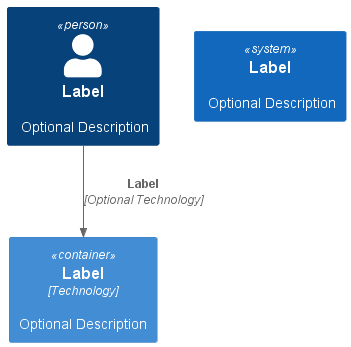
Final Project/Code/Gesture Control Final V2/plantuml/test.png
