RobbeElsermans/GestureControl/Final Project/PCB V0.3/Gesture Controller/GestureControlV0.3/GestureControl.kicad_pcb

## KiCad design Final Project/PCB V0.3/Gesture Controller/GestureControlV0.3/GestureControl.kicad_pcb (2022-03-24)

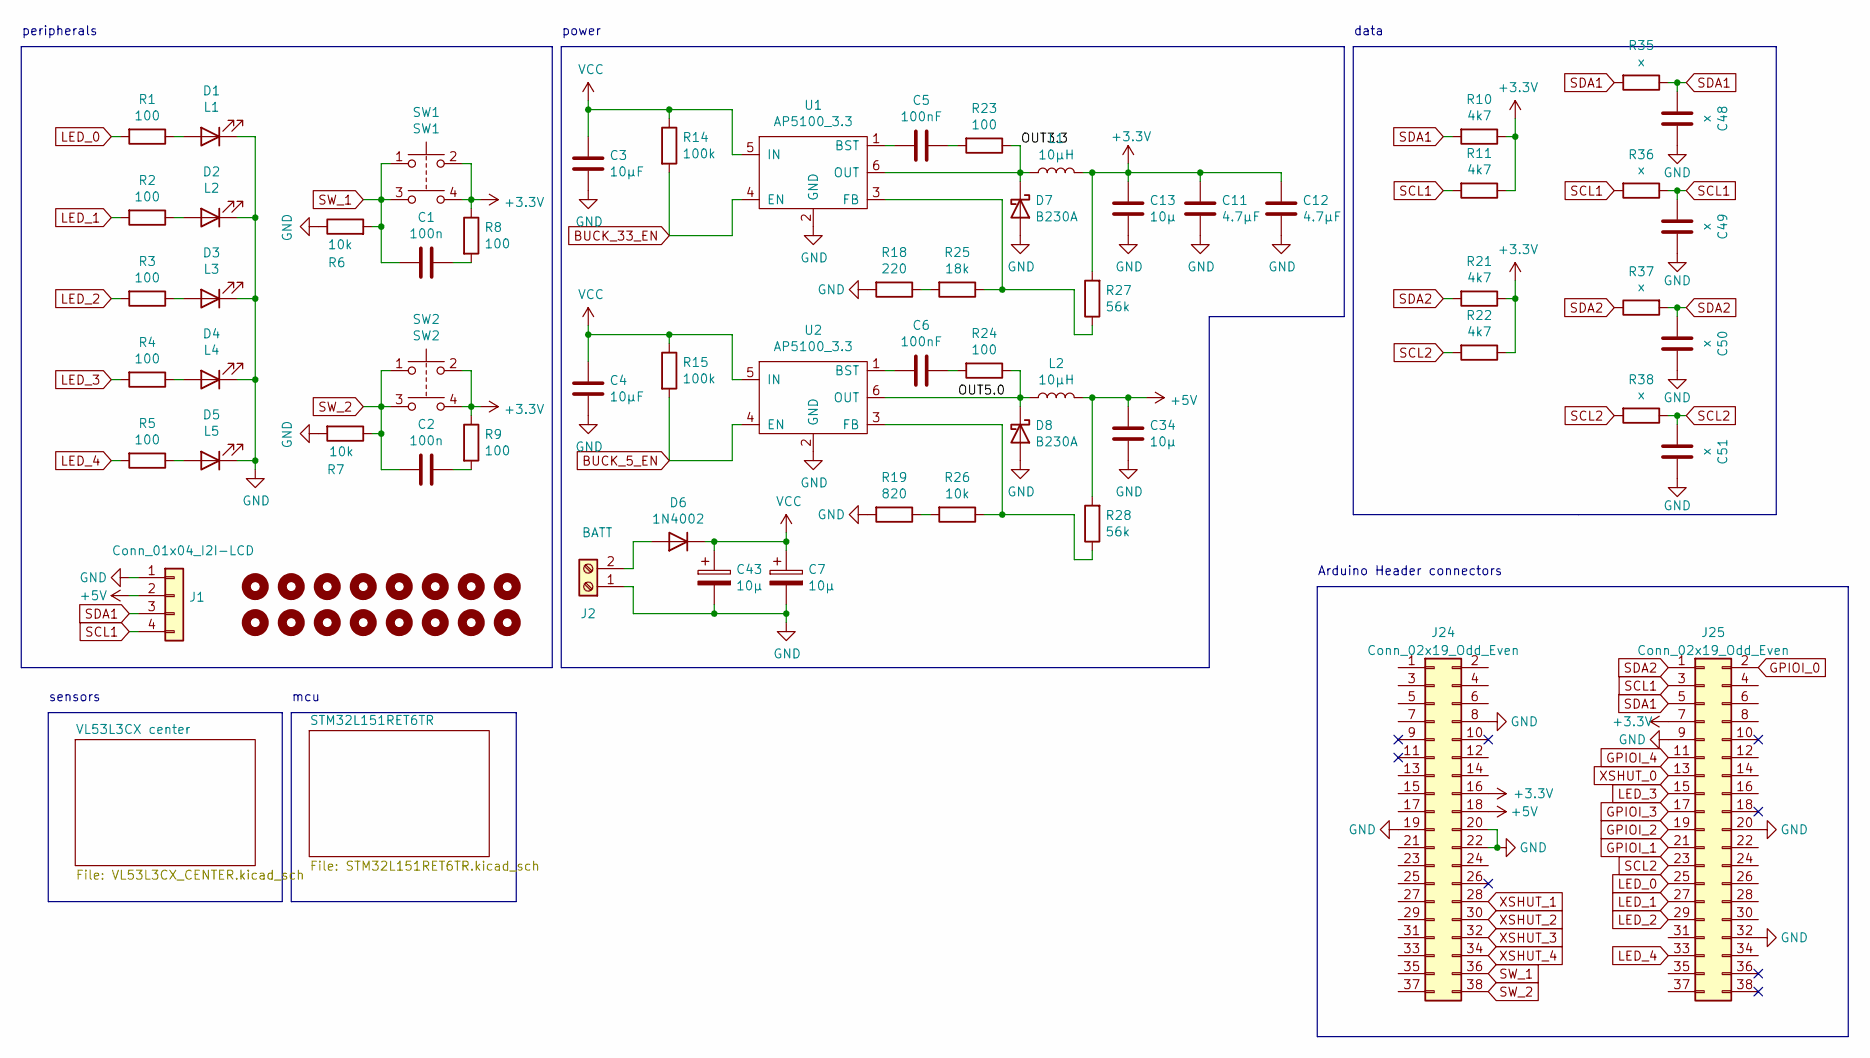
[picture p158: schematic GestureControl.kicad_sch, Gesture Control]

Parts:
C1, C2: 100n; C_0603_1608Metric_Pad1.08x0.95mm_HandSolder
C3, C4: 10µF; C_1206_3216Metric_Pad1.33x1.80mm_HandSolder
C5, C6: 100nF; C_0603_1608Metric_Pad1.08x0.95mm_HandSolder
C7, C43: 10µ; CP_Elec_6.3x5.4
C11, C12: 4.7µF; C_0805_2012Metric_Pad1.18x1.45mm_HandSolder
C13, C34: 10µ; C_1206_3216Metric_Pad1.33x1.80mm_HandSolder
C48, C49, C50, C51: x; C_0805_2012Metric_Pad1.18x1.45mm_HandSolder
D1: L1; LED_0805_2012Metric_Pad1.15x1.40mm_HandSolder
D2: L2; LED_0805_2012Metric_Pad1.15x1.40mm_HandSolder
D3: L3; LED_0805_2012Metric_Pad1.15x1.40mm_HandSolder
D4: L4; LED_0805_2012Metric_Pad1.15x1.40mm_HandSolder
D5: L5; LED_0805_2012Metric_Pad1.15x1.40mm_HandSolder
D6: 1N4002; D_SMA_Handsoldering
D7, D8: B230A; D_SMA_Handsoldering
H1, H2, H3, H4, H5, H6, H7, H8, H9, H10, H11, H12, H13, H14, H15, H16: MountingHole; MountingHole_3.2mm_M3
J1: Conn_01x04_I2I-LCD; PinHeader_1x04_P2.54mm_Vertical
J2: BATT; PhoenixContact_MC_1,5_2-G-3.5_1x02_P3.50mm_Horizontal
J24, J25: Conn_02x19_Odd_Even; PinSocket_2x19_P2.54mm_Vertical
L1, L2: 10µH; L_Taiyo-Yuden_NR-50xx_HandSoldering
R1, R2, R3, R4, R5, R8, R9, R23, R24: 100; R_0805_2012Metric_Pad1.20x1.40mm_HandSolder
R6, R7, R26: 10k; R_0805_2012Metric_Pad1.20x1.40mm_HandSolder
R10, R11, R21, R22: 4k7; R_0805_2012Metric_Pad1.20x1.40mm_HandSolder
R14, R15: 100k; R_0805_2012Metric_Pad1.20x1.40mm_HandSolder
R18: 220; R_0805_2012Metric_Pad1.20x1.40mm_HandSolder
R19: 820; R_0805_2012Metric_Pad1.20x1.40mm_HandSolder
R25: 18k; R_0805_2012Metric_Pad1.20x1.40mm_HandSolder
R27, R28: 56k; R_0805_2012Metric_Pad1.20x1.40mm_HandSolder
R35, R36, R37, R38: x; R_0805_2012Metric_Pad1.20x1.40mm_HandSolder
SW1: SW1; SW_Push_1P1T_NO_6x6mm_H9.5mm
SW2: SW2; SW_Push_1P1T_NO_6x6mm_H9.5mm
U1, U2: AP5100_3.3; TSOT-23-6_HandSoldering

Connections:
+3V3: C11.1, C12.1, C13.1, J24.16, J25.7, L1.2, R8.1, R9.1, R10.1, R11.1, R21.1, R22.1, R27.2, SW1.2, SW1.4, SW2.2, SW2.4; also elsewhere on the board
+5V: C34.1, J1.2, J24.18, L2.2, R28.2; also elsewhere on the board
/OUT3.3: D7.1 (K), L1.1, R23.1, U1.6 (OUT)
/OUT5.0: D8.1 (K), L2.1, R24.1, U2.6 (OUT)
BUCK_5_EN: R15.2, U2.4 (EN); also elsewhere on the board
BUCK_33_EN: R14.2, U1.4 (EN)
GND: C3.2, C4.2, C7.2, C11.2, C12.2, C13.2, C34.2, C43.2, C48.1, C49.1, C50.1, C51.1, D1.1 (K), D2.1 (K), D3.1 (K), D4.1 (K), D5.1 (K), D7.2 (A), D8.2 (A), J1.1, J2.1, J24.8, J24.19, J24.20, J24.22, J25.9, J25.20, J25.32, R6.1, R7.2, R18.2, R19.2, U1.2 (GND), U2.2 (GND); also elsewhere on the board
GPIOI_0: J25.2; also elsewhere on the board
GPIOI_1: J25.21; also elsewhere on the board
GPIOI_2: J25.19; also elsewhere on the board
GPIOI_3: J25.17; also elsewhere on the board
GPIOI_4: J25.11; also elsewhere on the board
LED_0: J25.25, R1.2; also elsewhere on the board
LED_1: J25.27, R2.2; also elsewhere on the board
LED_2: J25.29, R3.2; also elsewhere on the board
LED_3: J25.15, R4.2; also elsewhere on the board
LED_4: J25.33, R5.2; also elsewhere on the board
unnamed: C1.1, R8.2
unnamed: C2.1, R9.2
unnamed: C5.1, R23.2
unnamed: C5.2, U1.1 (BST)
unnamed: C6.1, R24.2
unnamed: C6.2, U2.1 (BST)
unnamed: D1.2 (A), R1.1
unnamed: D2.2 (A), R2.1
unnamed: D3.2 (A), R3.1
unnamed: D4.2 (A), R4.1
unnamed: D5.2 (A), R5.1
unnamed: D6.2 (A), J2.2
unnamed: R18.1, R25.2
unnamed: R19.1, R26.2
unnamed: R25.1, R27.1, U1.3 (FB)
unnamed: R26.1, R28.1, U2.3 (FB)
SCL1: C49.2, J1.4, J25.3, R11.2, R36.1, R36.2; also elsewhere on the board
SCL2: C51.2, J25.23, R22.2, R38.1, R38.2; also elsewhere on the board
SDA1: C48.2, J1.3, J25.5, R10.2, R35.1, R35.2; also elsewhere on the board
SDA2: C50.2, J25.1, R21.2, R37.1, R37.2; also elsewhere on the board
SW_1: C1.2, J24.36, R6.2, SW1.1, SW1.3; also elsewhere on the board
SW_2: C2.2, J24.38, R7.1, SW2.1, SW2.3; also elsewhere on the board
VCC: C3.1, C4.1, C7.1, C43.1, D6.1 (K), R14.1, R15.1, U1.5 (IN), U2.5 (IN)
XSHUT_0: J25.13; also elsewhere on the board
XSHUT_1: J24.28; also elsewhere on the board
XSHUT_2: J24.30; also elsewhere on the board
XSHUT_3: J24.32; also elsewhere on the board
XSHUT_4: J24.34; also elsewhere on the board

Notes on the sheet:
data
sensors
Arduino Header connectors
peripherals
mcu
power

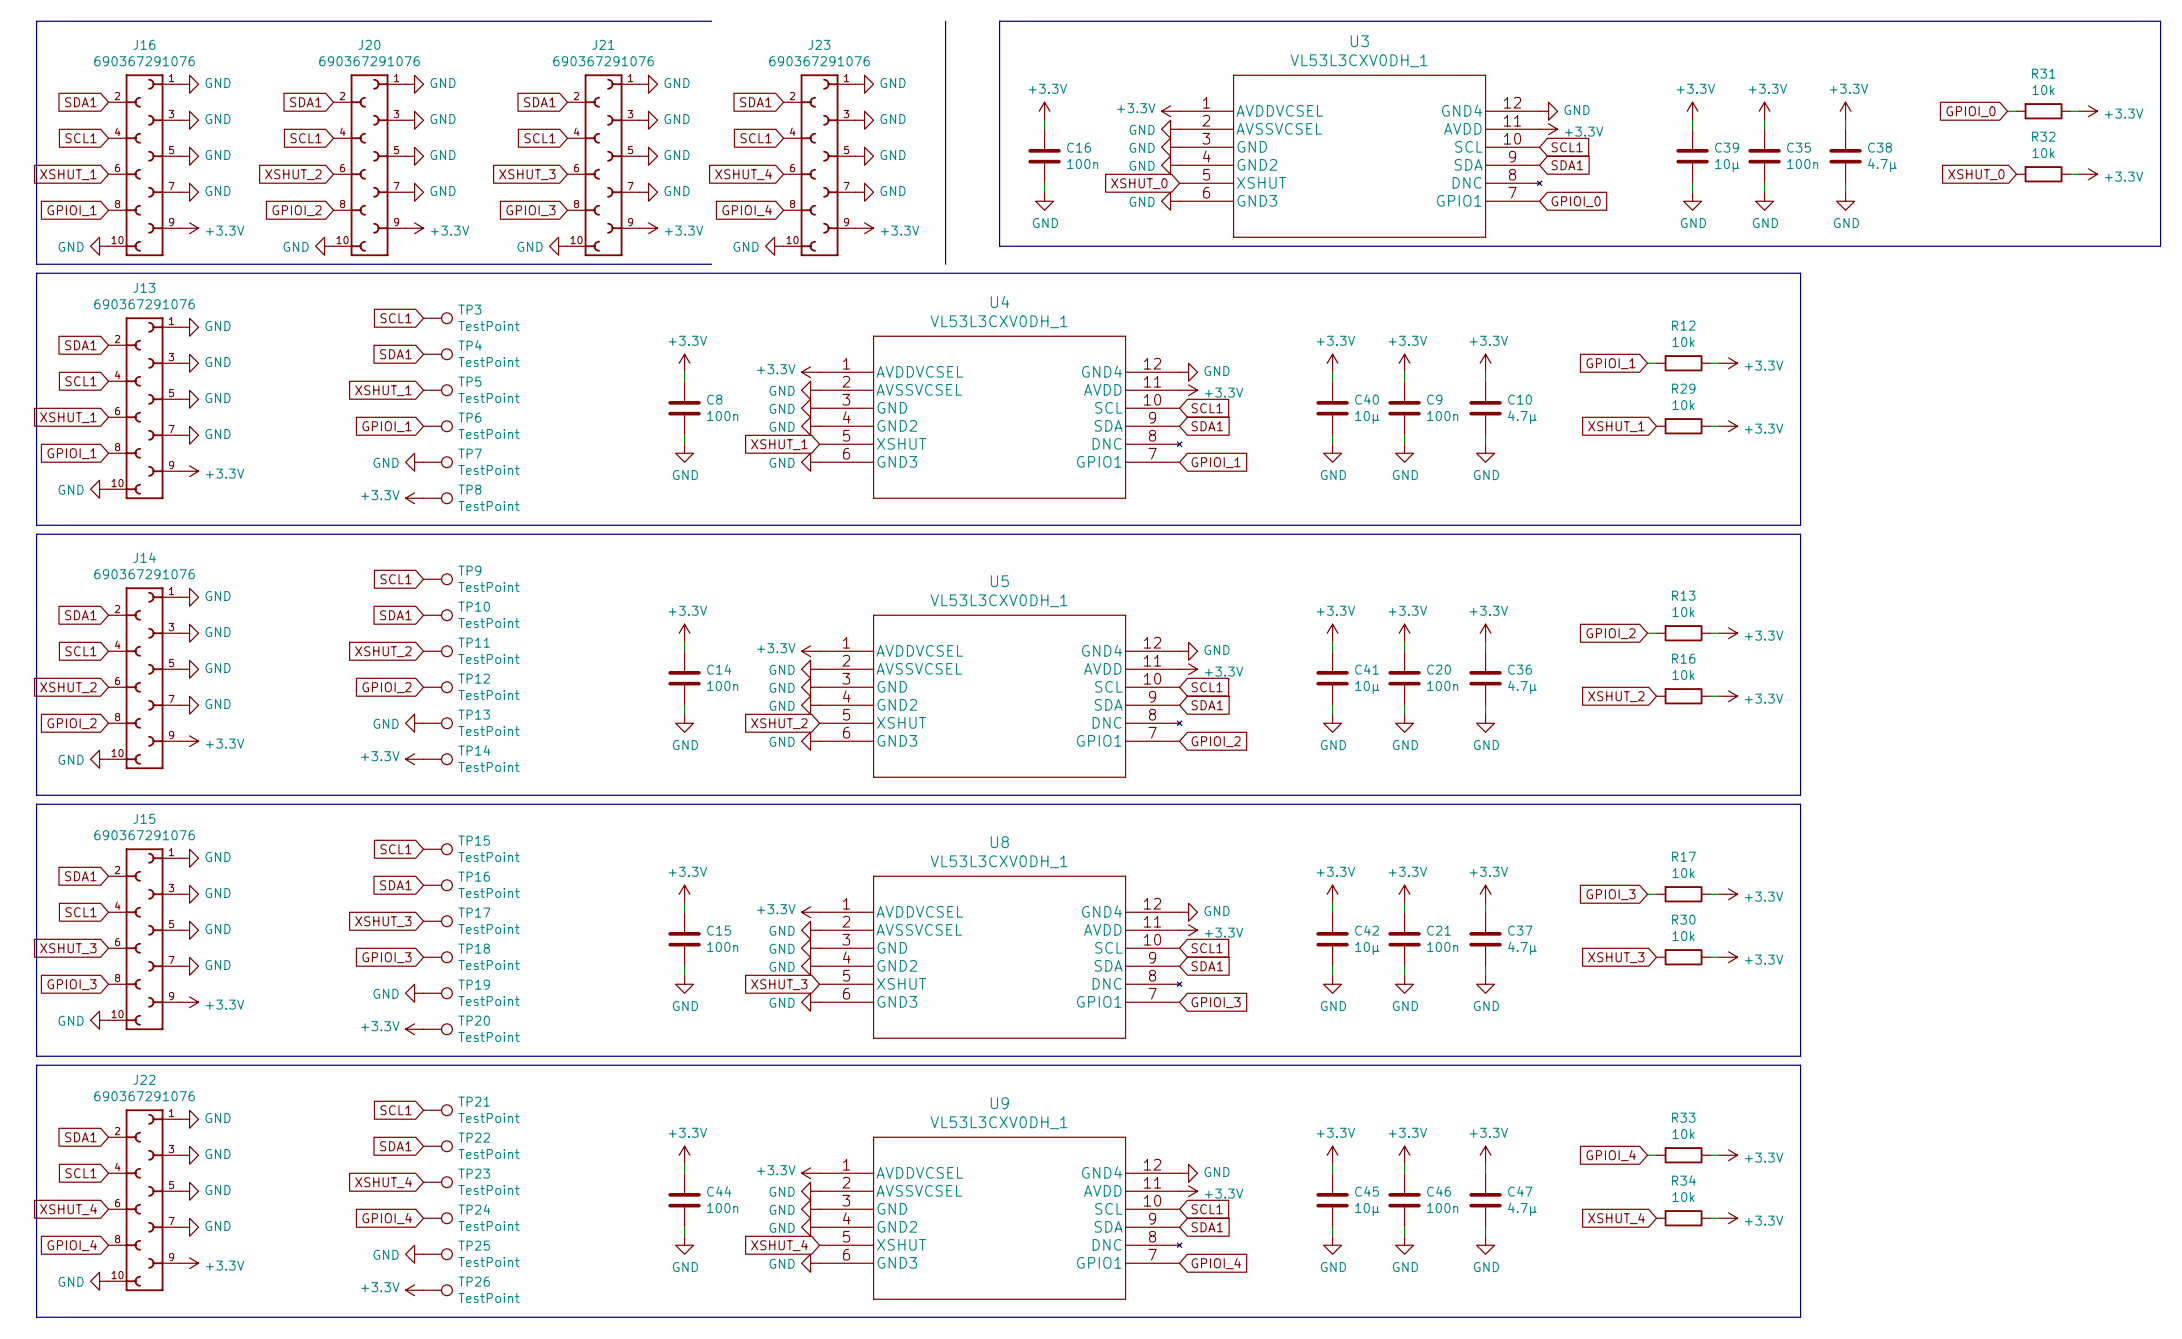
[picture p159: schematic VL53L3CX_CENTER.kicad_sch, Sensors]

Parts:
C8, C9, C14, C15, C16, C20, C21, C35, C44, C46: 100n; C_0603_1608Metric_Pad1.08x0.95mm_HandSolder
C10, C36, C37, C38, C47: 4.7µ; C_0805_2012Metric_Pad1.18x1.45mm_HandSolder
C39, C40, C41, C42, C45: 10µ; C_1206_3216Metric_Pad1.33x1.80mm_HandSolder
J13, J14, J15, J16, J20, J21, J22, J23: 690367291076; WR-MM_Female_SMT_Connector; PART-NUMBER 690367291076
R12, R13, R16, R17, R29, R30, R31, R32, R33, R34: 10k; R_0805_2012Metric_Pad1.20x1.40mm_HandSolder
TP3, TP4, TP5, TP6, TP7, TP8, TP9, TP10, TP11, TP12, TP13, TP14, TP15, TP16, TP17, TP18, TP19, TP20, TP21, TP22, TP23, TP24, TP25, TP26: TestPoint; TestPoint_Pad_D2.0mm
U3, U4, U5, U8, U9: VL53L3CXV0DH_1; VL53L3CXV0DH&slash_1

Connections:
+3V3: C8.1, C9.1, C10.1, C14.1, C15.1, C16.1, C20.1, C21.1, C35.1, C36.1, C37.1, C38.1, C39.1, C40.1, C41.1, C42.1, C44.1, C45.1, C46.1, C47.1, J13.9, J14.9, J15.9, J16.9, J20.9, J21.9, J22.9, J23.9, R12.1, R13.1, R16.1, R17.1, R29.1, R30.1, R31.1, R32.1, R33.1, R34.1, TP8.1, TP14.1, TP20.1, TP26.1, U3.1 (AVDDVCSEL), U3.11 (AVDD), U4.1 (AVDDVCSEL), U4.11 (AVDD), U5.1 (AVDDVCSEL), U5.11 (AVDD), U8.1 (AVDDVCSEL), U8.11 (AVDD), U9.1 (AVDDVCSEL), U9.11 (AVDD); also elsewhere on the board
GND: C8.2, C9.2, C10.2, C14.2, C15.2, C16.2, C20.2, C21.2, C35.2, C36.2, C37.2, C38.2, C39.2, C40.2, C41.2, C42.2, C44.2, C45.2, C46.2, C47.2, J13.1, J13.3, J13.5, J13.7, J13.10, J14.1, J14.3, J14.5, J14.7, J14.10, J15.1, J15.3, J15.5, J15.7, J15.10, J16.1, J16.3, J16.5, J16.7, J16.10, J20.1, J20.3, J20.5, J20.7, J20.10, J21.1, J21.3, J21.5, J21.7, J21.10, J22.1, J22.3, J22.5, J22.7, J22.10, J23.1, J23.3, J23.5, J23.7, J23.10, TP7.1, TP13.1, TP19.1, TP25.1, U3.2 (AVSSVCSEL), U3.3 (GND), U3.4 (GND2), U3.6 (GND3), U3.12 (GND4), U4.2 (AVSSVCSEL), U4.3 (GND), U4.4 (GND2), U4.6 (GND3), U4.12 (GND4), U5.2 (AVSSVCSEL), U5.3 (GND), U5.4 (GND2), U5.6 (GND3), U5.12 (GND4), U8.2 (AVSSVCSEL), U8.3 (GND), U8.4 (GND2), U8.6 (GND3), U8.12 (GND4), U9.2 (AVSSVCSEL), U9.3 (GND), U9.4 (GND2), U9.6 (GND3), U9.12 (GND4); also elsewhere on the board
GPIOI_0: R31.2, U3.7 (GPIO1); also elsewhere on the board
GPIOI_1: J13.8, J16.8, R12.2, TP6.1, U4.7 (GPIO1); also elsewhere on the board
GPIOI_2: J14.8, J20.8, R13.2, TP12.1, U5.7 (GPIO1); also elsewhere on the board
GPIOI_3: J15.8, J21.8, R17.2, TP18.1, U8.7 (GPIO1); also elsewhere on the board
GPIOI_4: J22.8, J23.8, R33.2, TP24.1, U9.7 (GPIO1); also elsewhere on the board
SCL1: J13.4, J14.4, J15.4, J16.4, J20.4, J21.4, J22.4, J23.4, TP3.1, TP9.1, TP15.1, TP21.1, U3.10 (SCL), U4.10 (SCL), U5.10 (SCL), U8.10 (SCL), U9.10 (SCL); also elsewhere on the board
SDA1: J13.2, J14.2, J15.2, J16.2, J20.2, J21.2, J22.2, J23.2, TP4.1, TP10.1, TP16.1, TP22.1, U3.9 (SDA), U4.9 (SDA), U5.9 (SDA), U8.9 (SDA), U9.9 (SDA); also elsewhere on the board
XSHUT_0: R32.2, U3.5 (XSHUT); also elsewhere on the board
XSHUT_1: J13.6, J16.6, R29.2, TP5.1, U4.5 (XSHUT); also elsewhere on the board
XSHUT_2: J14.6, J20.6, R16.2, TP11.1, U5.5 (XSHUT); also elsewhere on the board
XSHUT_3: J15.6, J21.6, R30.2, TP17.1, U8.5 (XSHUT); also elsewhere on the board
XSHUT_4: J22.6, J23.6, R34.2, TP23.1, U9.5 (XSHUT); also elsewhere on the board

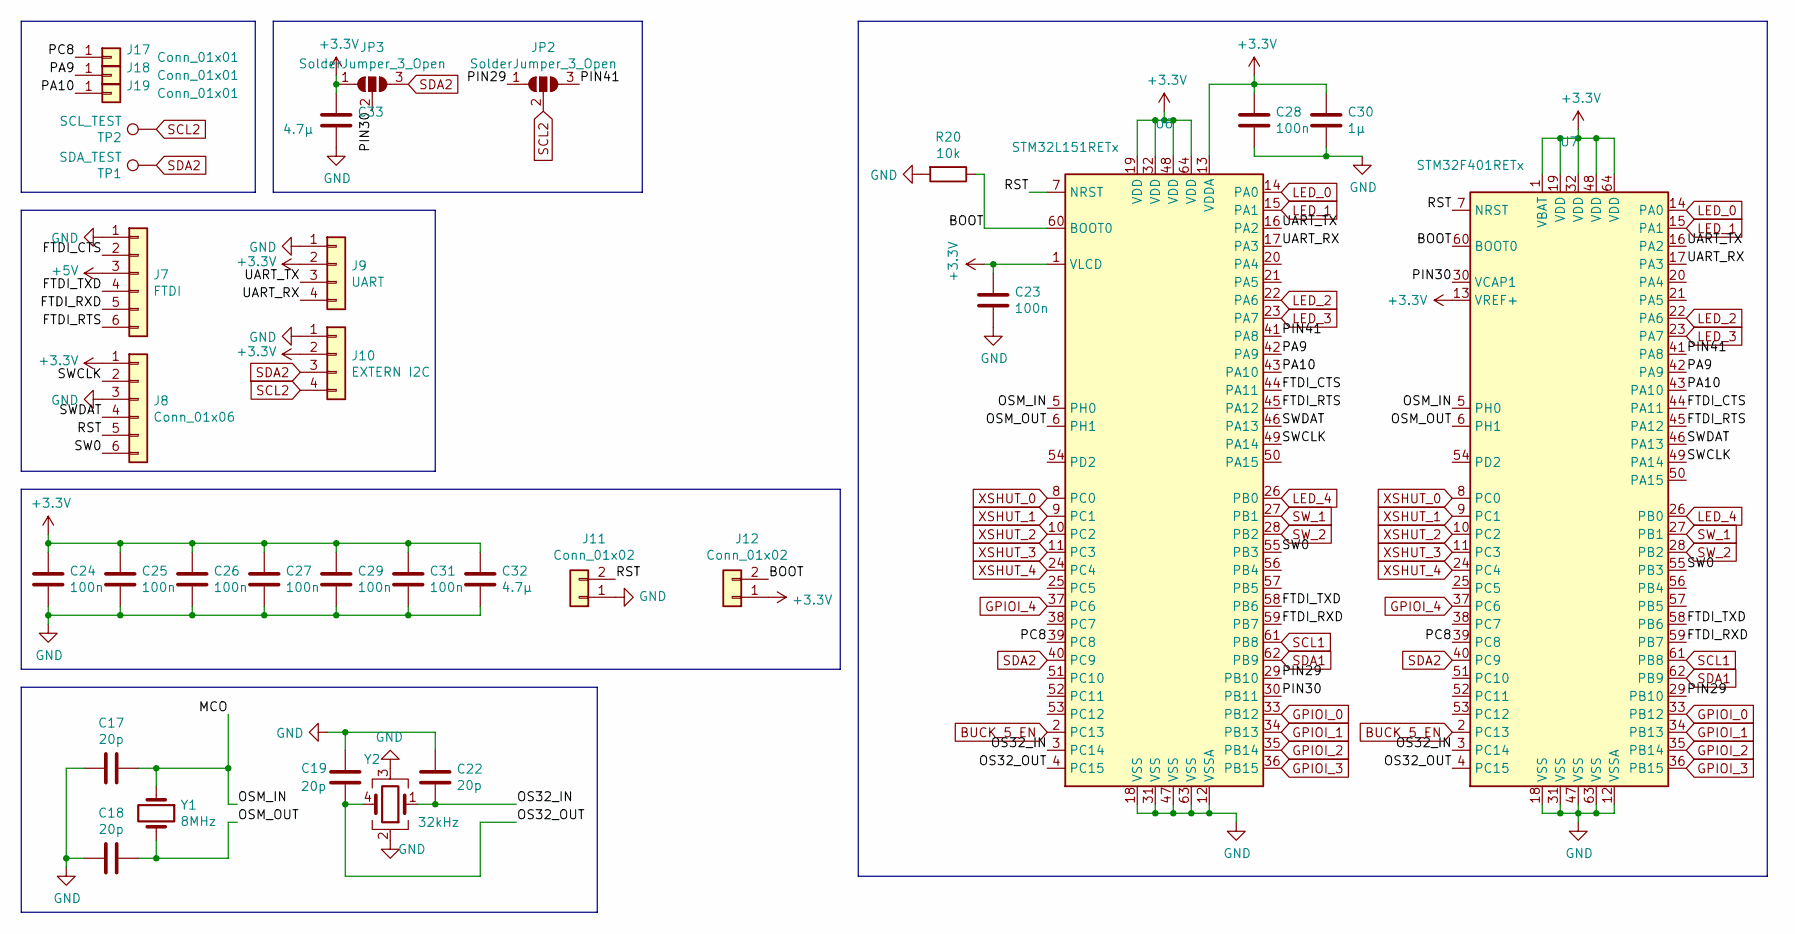
[picture p160: schematic STM32L151RET6TR.kicad_sch, MCU]

Parts:
C17, C18: 20p; C_0805_2012Metric_Pad1.18x1.45mm_HandSolder
C19, C22: 20p; C_0603_1608Metric_Pad1.08x0.95mm_HandSolder
C23, C24, C25, C26, C27, C28, C29, C31: 100n; C_0603_1608Metric_Pad1.08x0.95mm_HandSolder
C30: 1µ; C_0805_2012Metric_Pad1.18x1.45mm_HandSolder
C32, C33: 4.7µ; C_0805_2012Metric_Pad1.18x1.45mm_HandSolder
J7: FTDI; PinHeader_1x06_P2.54mm_Vertical
J8: Conn_01x06; PinHeader_1x06_P2.54mm_Vertical
J9: UART; PinHeader_1x04_P2.54mm_Vertical
J10: EXTERN I2C; PinHeader_1x04_P2.54mm_Vertical
J11, J12: Conn_01x02; PinHeader_1x02_P2.54mm_Vertical
J17, J18, J19: Conn_01x01; TestPoint_Pad_1.5x1.5mm
JP2, JP3: SolderJumper_3_Open; SolderJumper-3_P1.3mm_Open_RoundedPad1.0x1.5mm_NumberLabels
R20: 10k; R_0805_2012Metric_Pad1.20x1.40mm_HandSolder
TP1: SDA_TEST; TestPoint_Pad_1.0x1.0mm
TP2: SCL_TEST; TestPoint_Pad_1.0x1.0mm
U6: STM32L151RETx; LQFP-64_10x10mm_P0.5mm
U7: STM32F401RETx; LQFP-64_10x10mm_P0.5mm
Y1: 8MHz; Crystal_SMD_HC49-SD
Y2: 32kHz; Crystal_SMD_SeikoEpson_MC306-4Pin_8.0x3.2mm

Connections:
+3V3: C23.1, C24.1, C25.1, C26.1, C27.1, C28.1, C29.1, C30.1, C31.1, C32.1, C33.1, J8.1, J9.2, J10.2, J12.1, JP3.1 (A), U6.1 (VLCD), U6.13 (VDDA), U6.19 (VDD), U6.32 (VDD), U6.48 (VDD), U6.64 (VDD), U7.1 (VBAT), U7.13 (VREF+), U7.19 (VDD), U7.32 (VDD), U7.48 (VDD), U7.64 (VDD); also elsewhere on the board
+5V: J7.3; also elsewhere on the board
/STM32L151RET6TR/BOOT: J12.2, R20.1, U6.60 (BOOT0), U7.60 (BOOT0)
/STM32L151RET6TR/FTDI_CTS: J7.2, U6.44 (PA11), U7.44 (PA11)
/STM32L151RET6TR/FTDI_RTS: J7.6, U6.45 (PA12), U7.45 (PA12)
/STM32L151RET6TR/FTDI_RXD: J7.5, U6.59 (PB7), U7.59 (PB7)
/STM32L151RET6TR/FTDI_TXD: J7.4, U6.58 (PB6), U7.58 (PB6)
/STM32L151RET6TR/MCO: C17.1, U6.5 (PH0), U7.5 (PH0), Y1.1
/STM32L151RET6TR/OS32_IN: C22.2, U6.3 (PC14), U7.3 (PC14), Y2.1
/STM32L151RET6TR/OS32_OUT: C19.2, U6.4 (PC15), U7.4 (PC15), Y2.4
/STM32L151RET6TR/OSM_OUT: C18.1, U6.6 (PH1), U7.6 (PH1), Y1.2
/STM32L151RET6TR/PA9: J18.1, U6.42 (PA9), U7.42 (PA9)
/STM32L151RET6TR/PA10: J19.1, U6.43 (PA10), U7.43 (PA10)
/STM32L151RET6TR/PC8: J17.1, U6.39 (PC8), U7.39 (PC8)
/STM32L151RET6TR/PIN29: JP2.1 (A), U6.29 (PB10), U7.29 (PB10)
/STM32L151RET6TR/PIN30: JP3.2 (C), U6.30 (PB11), U7.30 (VCAP1)
/STM32L151RET6TR/PIN41: JP2.3 (B), U6.41 (PA8), U7.41 (PA8)
/STM32L151RET6TR/RST: J8.5, J11.2, U6.7 (NRST), U7.7 (NRST)
/STM32L151RET6TR/SW0: J8.6, U6.55 (PB3), U7.55 (PB3)
/STM32L151RET6TR/SWCLK: J8.2, U6.49 (PA14), U7.49 (PA14)
/STM32L151RET6TR/SWDAT: J8.4, U6.46 (PA13), U7.46 (PA13)
/STM32L151RET6TR/UART_RX: J9.4, U6.17 (PA3), U7.17 (PA3)
/STM32L151RET6TR/UART_TX: J9.3, U6.16 (PA2), U7.16 (PA2)
BUCK_5_EN: U6.2 (PC13), U7.2 (PC13); also elsewhere on the board
GND: C17.2, C18.2, C19.1, C22.1, C23.2, C24.2, C25.2, C26.2, C27.2, C28.2, C29.2, C30.2, C31.2, C32.2, C33.2, J7.1, J8.3, J9.1, J10.1, J11.1, R20.2, U6.12 (VSSA), U6.18 (VSS), U6.31 (VSS), U6.47 (VSS), U6.63 (VSS), U7.12 (VSSA), U7.18 (VSS), U7.31 (VSS), U7.47 (VSS), U7.63 (VSS), Y2.2, Y2.3; also elsewhere on the board
GPIOI_0: U6.33 (PB12), U7.33 (PB12); also elsewhere on the board
GPIOI_1: U6.34 (PB13), U7.34 (PB13); also elsewhere on the board
GPIOI_2: U6.35 (PB14), U7.35 (PB14); also elsewhere on the board
GPIOI_3: U6.36 (PB15), U7.36 (PB15); also elsewhere on the board
GPIOI_4: U6.37 (PC6), U7.37 (PC6); also elsewhere on the board
LED_0: U6.14 (PA0), U7.14 (PA0); also elsewhere on the board
LED_1: U6.15 (PA1), U7.15 (PA1); also elsewhere on the board
LED_2: U6.22 (PA6), U7.22 (PA6); also elsewhere on the board
LED_3: U6.23 (PA7), U7.23 (PA7); also elsewhere on the board
LED_4: U6.26 (PB0), U7.26 (PB0); also elsewhere on the board
SCL1: U6.61 (PB8), U7.61 (PB8); also elsewhere on the board
SCL2: J10.4, JP2.2 (C), TP2.1; also elsewhere on the board
SDA1: U6.62 (PB9), U7.62 (PB9); also elsewhere on the board
SDA2: J10.3, JP3.3 (B), TP1.1, U6.40 (PC9), U7.40 (PC9); also elsewhere on the board
SW_1: U6.27 (PB1), U7.27 (PB1); also elsewhere on the board
SW_2: U6.28 (PB2), U7.28 (PB2); also elsewhere on the board
XSHUT_0: U6.8 (PC0), U7.8 (PC0); also elsewhere on the board
XSHUT_1: U6.9 (PC1), U7.9 (PC1); also elsewhere on the board
XSHUT_2: U6.10 (PC2), U7.10 (PC2); also elsewhere on the board
XSHUT_3: U6.11 (PC3), U7.11 (PC3); also elsewhere on the board
XSHUT_4: U6.24 (PC4), U7.24 (PC4); also elsewhere on the board

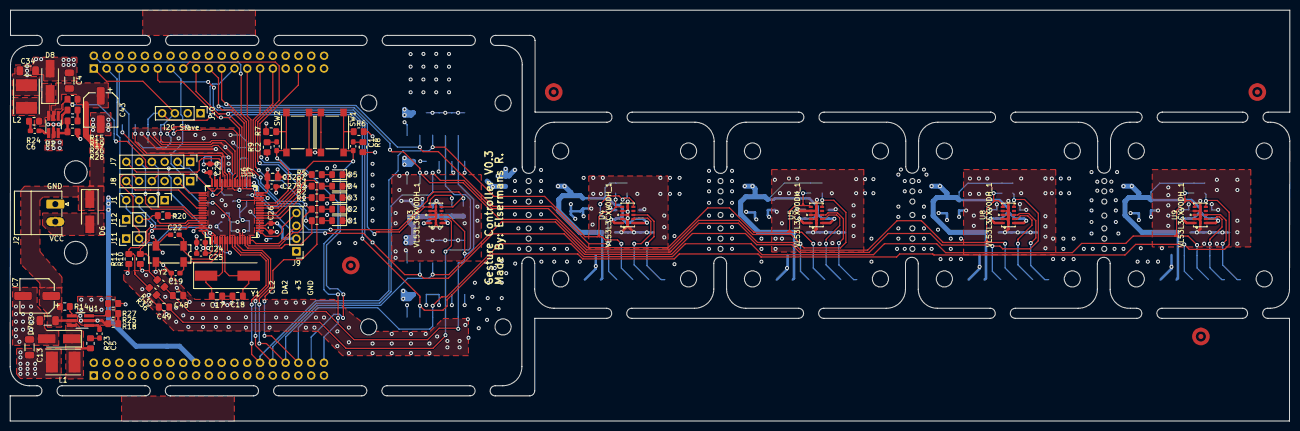
[picture p161: board GestureControl.kicad_pcb from above]

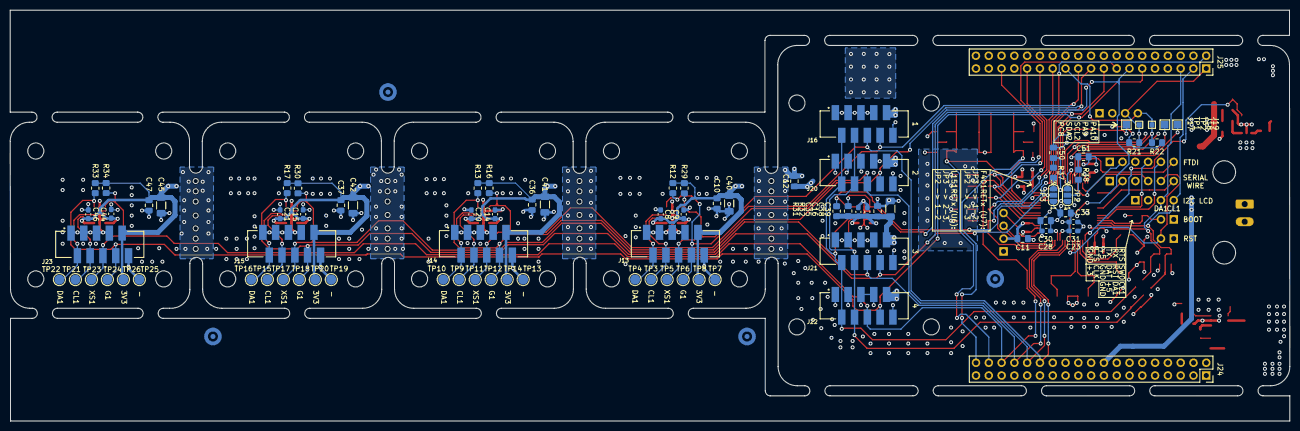
[picture p162: board GestureControl.kicad_pcb from below]

Board: 4 copper layers, 254.1 x 81.6 mm, 181 parts (84 on the bottom side), 66 nets.

Other parts of the board:
H13#2, H14#2, H15#2, H16#2: MountingHole; MountingHole_3.2mm_M3
