RobbeElsermans/GestureControl/pcb/LED Controller/Led_Controller/Led_Controller.kicad_sch

## KiCad design pcb/LED Controller/Led_Controller/Led_Controller.kicad_sch (2022-05-23)

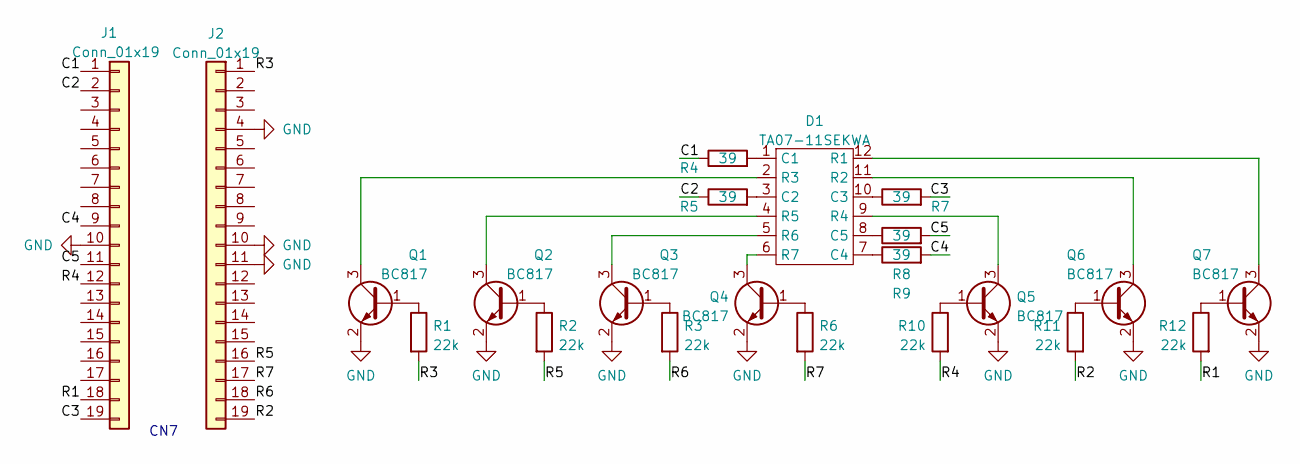
[picture p163: schematic Led_Controller.kicad_sch]

Parts:
D1: TA07-11SEKWA
J1, J2: Conn_01x19
Q1, Q2, Q3, Q4, Q5, Q6, Q7: BC817; SOT-23
R1, R2, R3, R6, R10, R11, R12: 22k
R4, R5, R7, R8, R9: 39

Connections:
C1: J1.1, R4.1
C2: J1.2, R5.1
C3: J1.19, R7.2
C4: J1.9, R9.2
C5: J1.11, R8.2
GND: J1.10, J2.4, J2.10, J2.11, Q1.2 (E), Q2.2 (E), Q3.2 (E), Q4.2 (E), Q5.2 (E), Q6.2 (E), Q7.2 (E)
unnamed: D1.1 (C1), R4.2
unnamed: D1.2 (R3), Q1.3 (C)
unnamed: D1.3 (C2), R5.2
unnamed: D1.4 (R5), Q2.3 (C)
unnamed: D1.5 (R6), Q3.3 (C)
unnamed: D1.6 (R7), Q4.3 (C)
unnamed: D1.7 (C4), R9.1
unnamed: D1.8 (C5), R8.1
unnamed: D1.9 (R4), Q5.3 (C)
unnamed: D1.10 (C3), R7.1
unnamed: D1.11 (R2), Q6.3 (C)
unnamed: D1.12 (R1), Q7.3 (C)
unnamed: Q1.1 (B), R1.1
unnamed: Q2.1 (B), R2.1
unnamed: Q3.1 (B), R3.1
unnamed: Q4.1 (B), R6.1
unnamed: Q5.1 (B), R10.1
unnamed: Q6.1 (B), R11.1
unnamed: Q7.1 (B), R12.1
R1: J1.18, R12.2
R2: J2.19, R11.2
R3: J2.1, R1.2
R4: J1.12, R10.2
R5: J2.16, R2.2
R6: J2.18, R3.2
R7: J2.17, R6.2

Notes on the sheet:
CN7
