RobbeElsermans/GestureControl/Code PlatformIO/Gesture Control Bare Bone/include/main.h

#define SW_2_Pin GPIO_PIN_0
#define SW_2_GPIO_Port GPIOC
#define SW_1_Pin GPIO_PIN_1
#define SW_1_GPIO_Port GPIOC
#define XSHUT_1_Pin GPIO_PIN_0
#define XSHUT_1_GPIO_Port GPIOA
#define XSHUT_2_Pin GPIO_PIN_1
#define XSHUT_2_GPIO_Port GPIOA
#define USART_TX_Pin GPIO_PIN_2
#define USART_TX_GPIO_Port GPIOA
#define USART_RX_Pin GPIO_PIN_3
#define USART_RX_GPIO_Port GPIOA
#define XSHUT_3_Pin GPIO_PIN_4
#define XSHUT_3_GPIO_Port GPIOA
#define GPIOI_4_Pin GPIO_PIN_5
#define GPIOI_4_GPIO_Port GPIOA
#define GPIOI_4_EXTI_IRQn EXTI9_5_IRQn
#define XSHUT_0_Pin GPIO_PIN_6
#define XSHUT_0_GPIO_Port GPIOA
#define LED_3_Pin GPIO_PIN_7
#define LED_3_GPIO_Port GPIOA
#define XSHUT_4_Pin GPIO_PIN_0
#define XSHUT_4_GPIO_Port GPIOB
#define LED_0_Pin GPIO_PIN_10
#define LED_0_GPIO_Port GPIOB
#define GPIOI_2_Pin GPIO_PIN_7
#define GPIOI_2_GPIO_Port GPIOC
#define GPIOI_2_EXTI_IRQn EXTI9_5_IRQn
#define GPIOI_0_Pin GPIO_PIN_8
#define GPIOI_0_GPIO_Port GPIOC
#define GPIOI_0_EXTI_IRQn EXTI9_5_IRQn
#define GPIOI_1_Pin GPIO_PIN_9
#define GPIOI_1_GPIO_Port GPIOA
#define GPIOI_1_EXTI_IRQn EXTI9_5_IRQn
#define LED_4_Pin GPIO_PIN_10
#define LED_4_GPIO_Port GPIOA
#define TMS_Pin GPIO_PIN_13
#define TMS_GPIO_Port GPIOA
#define TCK_Pin GPIO_PIN_14
#define TCK_GPIO_Port GPIOA
#define SWO_Pin GPIO_PIN_3
#define SWO_GPIO_Port GPIOB
#define LED_1_Pin GPIO_PIN_4
#define LED_1_GPIO_Port GPIOB
#define LED_2_Pin GPIO_PIN_5
#define LED_2_GPIO_Port GPIOB
#define GPIOI_3_Pin GPIO_PIN_6
#define GPIOI_3_GPIO_Port GPIOB
#define GPIOI_3_EXTI_IRQn EXTI9_5_IRQn
