RobbeElsermans/GestureControl/Final Project/Code/Gesture Control Final V2/src/BSP.c

/**
 * @file BSP.c
 * @author Robbe Elsermans (robbe.elsermans@student.ap.be)
 * @brief High level driver die een verzameling zal bevatten van de geschreven abstractie layers
 * @version 1.0
 * @date 2022-05-20
 * 
 * This software is licensed under terms that can be found in the LICENSE file in the root directory of this software component.
 * If no LICENSE file comes with this software, it is provided AS-IS and shared in the Public Domain
 * 
 */
#include "BSP.h"
#include "stm32f3xx_hal.h"

void SystemClock_Config(void);

void BSP_initBSP(){
    HAL_Init();
    SystemClock_Config();
    timer_delay(1);
    gpio_initGpio();
    timer_delay(1);
    I2C2_init();
    timer_delay(1);
    USART1_initUart();
    timer_delay(1);
    BSP_I2C1_Init();
    timer_delay(1);
}


void SystemClock_Config(void)
{
  RCC_OscInitTypeDef RCC_OscInitStruct = {0};
  RCC_ClkInitTypeDef RCC_ClkInitStruct = {0};
  RCC_PeriphCLKInitTypeDef PeriphClkInit = {0};

  /** Initializes the RCC Oscillators according to the specified parameters
  * in the RCC_OscInitTypeDef structure.
  */
  RCC_OscInitStruct.OscillatorType = RCC_OSCILLATORTYPE_HSE;
  RCC_OscInitStruct.HSEState = RCC_HSE_ON;
  RCC_OscInitStruct.HSEPredivValue = RCC_HSE_PREDIV_DIV1;
  RCC_OscInitStruct.HSIState = RCC_HSI_ON;
  RCC_OscInitStruct.PLL.PLLState = RCC_PLL_ON;
  RCC_OscInitStruct.PLL.PLLSource = RCC_PLLSOURCE_HSE;
  RCC_OscInitStruct.PLL.PLLMUL = RCC_PLL_MUL2;
  if (HAL_RCC_OscConfig(&RCC_OscInitStruct) != HAL_OK)
  {
    __disable_irq();
    while (1)
    {
    }
  }
  /** Initializes the CPU, AHB and APB buses clocks
  */
  RCC_ClkInitStruct.ClockType = RCC_CLOCKTYPE_HCLK|RCC_CLOCKTYPE_SYSCLK
                              |RCC_CLOCKTYPE_PCLK1|RCC_CLOCKTYPE_PCLK2;
  RCC_ClkInitStruct.SYSCLKSource = RCC_SYSCLKSOURCE_PLLCLK;
  RCC_ClkInitStruct.AHBCLKDivider = RCC_SYSCLK_DIV1;
  RCC_ClkInitStruct.APB1CLKDivider = RCC_HCLK_DIV2;
  RCC_ClkInitStruct.APB2CLKDivider = RCC_HCLK_DIV1;

  if (HAL_RCC_ClockConfig(&RCC_ClkInitStruct, FLASH_LATENCY_0) != HAL_OK)
  {
    __disable_irq();
    while (1)
    {
    }
  }
  PeriphClkInit.PeriphClockSelection = RCC_PERIPHCLK_USART1|RCC_PERIPHCLK_I2C1
                              |RCC_PERIPHCLK_I2C2;
  PeriphClkInit.Usart1ClockSelection = RCC_USART1CLKSOURCE_PCLK2;
  PeriphClkInit.I2c1ClockSelection = RCC_I2C1CLKSOURCE_SYSCLK;
  PeriphClkInit.I2c2ClockSelection = RCC_I2C2CLKSOURCE_SYSCLK;
  if (HAL_RCCEx_PeriphCLKConfig(&PeriphClkInit) != HAL_OK)
  {
    __disable_irq();
    while (1)
    {
    }
  }
  //HAL_RCC_MCOConfig(RCC_MCO, RCC_MCO1SOURCE_SYSCLK, RCC_MCODIV_1);
}
