RobbeElsermans/GestureControl/Final Project/Code/Gesture Control Final V2/python/showDataCSV.py

#!/usr/bin/python

# Made By Robbe Elsermans
# Dit python script gebruik je wanneer je een CSV bestand hebt gegenereerd door storeDataCSV.py.

from csv import reader
import matplotlib.pyplot as plt

fileName = "data_2022-05-09_112718"

file = open("logs/" + fileName + ".csv", 'r', newline='')

data = reader(file, delimiter=',')

left=[]
center=[]
right=[]

for items in data:
    if not("LEFT" in items[0]):
        left.append(int(items[0]))
        center.append(int(items[1]))
        right.append(int(items[2]))

#aanmaken x as
x = range(len(left))

plt.plot(x,left,label="left")
plt.plot(x,center,label="center")
plt.plot(x,right,label="right")
plt.legend()
plt.show()
