RobbeElsermans/GestureControl/Final Project/Code/Gesture Control Final V2/test/button_test.h

#ifndef UNIT_BUTTON_TEST_H
#define UNIT_BUTTON_TEST_H

#include <unity.h>
#include "gpio.h"
#include "stdbool.h" //Nodig om bool te kunnen gebruiken
#include "stm32f3xx_hal.h"
#include "main.h"

void run_button_test();

#endif
