RobbeElsermans/GestureControl/(commit log)

2022-02-16 initialize pcb
    [GestureControl.kicad_pcb, GestureControl.sch]
2022-02-16 add lib for kicad
2022-02-18 before timer
2022-02-18 revert timer
2022-02-21 end simple schematic
    [GestureControl.sch]
2022-02-21 add MCU + PCB
    [GestureControl.csv, GestureControl.sch, STM32F401RET6U.sch, VL53L3CX_CENTER.sch, VL53L3CX_LEFT.sch, VL53L3CX_RIGHT.sch]
2022-02-21 edit PCB
    [GestureControl.kicad_pcb]
2022-02-22 add BOM + schematic pdf
    [GestureControl.csv]
2022-02-23 new PCB
    [GestureControl.kicad_pcb, GestureControl.sch, GestureControlV0.1.kicad_pcb, STM32F401RET6U.sch, STM32L151RET6TR.sch, STM32L151ZCT6.sch, VL53L3CX_CENTER.sch, VL53L3CX_LEFT.sch]
2022-02-24 add lib inside PCB
    [GestureControl-B_Mask.gbr, GestureControl-B_Paste.gbr, GestureControl-B_SilkS.gbr, GestureControl-Edge_Cuts.gbr, GestureControl-F_Mask.gbr, GestureControl-F_Paste.gbr, GestureControl-F_SilkS.gbr, GestureControl-GND.gbr]
2022-02-24 begin verwerking feedback Stef
    [GestureControl.kicad_pcb, GestureControl.sch, STM32L151RET6TR.sch]
2022-02-24 eind tekenen PCB
    [GestureControl.kicad_pcb, STM32L151RET6TR.sch]
2022-02-24 add text pcb
    [GestureControl-B_Mask.gbr, GestureControl-B_Paste.gbr, GestureControl-B_SilkS.gbr, GestureControl-Edge_Cuts.gbr, GestureControl-F_Mask.gbr, GestureControl-F_Paste.gbr, GestureControl-F_SilkS.gbr, GestureControl-GND.gbr]
2022-02-25 add feedback Philip
    [GestureControl-B_Mask.gbr, GestureControl-B_Paste.gbr, GestureControl-B_SilkS.gbr, GestureControl-Edge_Cuts.gbr, GestureControl-F_Mask.gbr, GestureControl-F_Paste.gbr, GestureControl-F_SilkS.gbr, GestureControl-GND.gbr]
2022-02-25 werking printf()
    [GestureControl-B_Mask.gbr, GestureControl-B_Paste.gbr, GestureControl-B_SilkS.gbr, GestureControl-Edge_Cuts.gbr, GestureControl-F_Mask.gbr, GestureControl-F_Paste.gbr, GestureControl-F_SilkS.gbr, GestureControl-GND.gbr]
2022-02-25 fail import driver
2022-02-25 add project stm32cubeide clean
2022-02-25 add rintf to stm32cubeide
2022-02-25 fail import in vscode
    [GestureControl.ioc, main.cpp, main.h]
2022-02-28 add PCBV0.11
    [GestureControl.kicad_pcb, GestureControl.kicad_pcbV0.1.kicad_pcb, GestureControl.sch, GestureControlV0.1.kicad_pcb, GestureControlV0.1.sch, STM32L151RET6TR.sch, VL53L3CX_CENTER.sch, VL53L3CX_LEFT.sch]
2022-02-28 add zip PCBV0.11
2022-02-28 add librarys KiCAD
2022-02-28 update board design
    [GestureControl.kicad_pcb, GestureControl.sch]
2022-03-01 pcb groter maken
    [GestureControl.kicad_pcb]
2022-03-03 add PCB V12
    [GestureControl.kicad_pcb, GestureControl.sch, STM32L151RET6TR.sch, VL53L3CX_CENTER.sch, VL53L3CX_LEFT.sch, VL53L3CX_RIGHT.sch]
2022-03-04 cleanup PCB V0.1
    [GestureControl-B_Mask.gbr, GestureControl-B_Paste.gbr, GestureControl-B_SilkS.gbr, GestureControl-Edge_Cuts.gbr, GestureControl-F_Mask.gbr, GestureControl-F_Paste.gbr, GestureControl-F_SilkS.gbr, GestureControl-GND.gbr]
2022-03-04 add Command switch
2022-03-07 bug fix "commando blijft aan"
    [app_tof.c]
2022-03-07 bug fix "cammand RL/ LR na dimming"
    [app_tof.c]
2022-03-07 add breakout mal
    [breakoutboard-holderV1.stl, breakoutboard-holderV2.stl, breakoutboard.FCStd]
2022-03-07 save 3d
    [breakoutboard.FCStd]
2022-03-08 add calibrations + corrections + offset
    [app_tof.c]
2022-03-08 add box
    [breakoutboard-sensor_bak.stl, breakoutboard.FCStd]
2022-03-10 add feedback PCB
    [GestureControl-B_Cu.gbr, GestureControl-B_Mask.gbr, GestureControl-B_Paste.gbr, GestureControl-B_SilkS.gbr, GestureControl-B_Silkscreen.gbr, GestureControl-Edge_Cuts.gbr, GestureControl-F_Cu.gbr, GestureControl-F_Mask.gbr]
2022-03-11 end PCB V0.15
    [GestureControl-B_Cu.gbr, GestureControl-B_Mask.gbr, GestureControl-B_Paste.gbr, GestureControl-B_Silkscreen.gbr, GestureControl-Edge_Cuts.gbr, GestureControl-F_Cu.gbr, GestureControl-F_Mask.gbr, GestureControl-F_Paste.gbr]
2022-03-11 add breakoutboard
    [GestureControl-B_Cu.gbr, GestureControl-B_Mask.gbr, GestureControl-B_Paste.gbr, GestureControl-B_Silkscreen.gbr, GestureControl-Edge_Cuts.gbr, GestureControl-F_Cu.gbr, GestureControl-F_Mask.gbr, GestureControl-F_Paste.gbr]
2022-03-11 werking sensor 3 & 4
2022-03-14 add docs
    [GestureControl.kicad_sch, STM32L151RET6TR.kicad_sch]
2022-03-14 small change
    [GestureControl.kicad_pcb]
2022-03-15 feedback verwerking philip
    [GestureControl.kicad_pcb]
2022-03-17 feedback verwerling philip
    [GestureControl-B_Cu.gbr, GestureControl-B_Mask.gbr, GestureControl-B_Paste.gbr, GestureControl-B_Silkscreen.gbr, GestureControl-Edge_Cuts.gbr, GestureControl-F_Cu.gbr, GestureControl-F_Mask.gbr, GestureControl-F_Paste.gbr]
2022-03-18 add master & slave i2c
2022-03-18 add button cal + cleanup
2022-03-18 add led controller
2022-03-18 add commands led controller
2022-03-18 add vias
    [GestureControl-B_Cu.gbr, GestureControl-B_Mask.gbr, GestureControl-B_Paste.gbr, GestureControl-B_Silkscreen.gbr, GestureControl-Edge_Cuts.gbr, GestureControl-F_Cu.gbr, GestureControl-F_Mask.gbr, GestureControl-F_Paste.gbr]
2022-03-21 ADD RC op I2C
    [GestureControl-B_Cu.gbr, GestureControl-B_Mask.gbr, GestureControl-B_Paste.gbr, GestureControl-B_Silkscreen.gbr, GestureControl-Edge_Cuts.gbr, GestureControl-F_Cu.gbr, GestureControl-F_Mask.gbr, GestureControl-F_Paste.gbr]
2022-03-21 add zip
    [GestureControl-B_Cu.gbr, GestureControl-B_Mask.gbr, GestureControl-B_Paste.gbr, GestureControl-B_Silkscreen.gbr, GestureControl-Edge_Cuts.gbr, GestureControl-F_Cu.gbr, GestureControl-F_Mask.gbr, GestureControl-F_Paste.gbr]
2022-03-21 add buttonCali
2022-03-21 werking interrupt zonder objectpresent
2022-03-21 werking interrupt met object present
    Kleine bug bij hand dat ineens weg valt
    [app_tof.c]
2022-03-22 werking led controller basic
2022-03-22 werking led controller basic V2
2022-03-22 werking led controller
2022-03-24 add PCBV0.23
    [GestureControl-B_Cu.gbr, GestureControl-B_Mask.gbr, GestureControl-B_Paste.gbr, GestureControl-B_Silkscreen.gbr, GestureControl-Edge_Cuts.gbr, GestureControl-F_Cu.gbr, GestureControl-F_Mask.gbr, GestureControl-F_Paste.gbr]
2022-03-24 add PCBV0.3
    [GestureControl-B_Cu.gbr, GestureControl-B_Mask.gbr, GestureControl-B_Paste.gbr, GestureControl-B_Silkscreen.gbr, GestureControl-Edge_Cuts.gbr, GestureControl-F_Cu.gbr, GestureControl-F_Mask.gbr, GestureControl-F_Paste.gbr]
2022-03-24 edit docs
    [GestureControl.kicad_sch]
2022-03-24 backuo kicad
2022-03-25 add onderzoek plaats sensoren
    [breakoutboard-Holder_Botton.stl, breakoutboard-Holder_Top.stl, breakoutboard-bottom.step, breakoutboard-holderV2.step, breakoutboard-holderV2.stl, breakoutboard-top.step, breakoutboard.stl]
2022-03-29 opkuis schema
    [VL53L3CX_CENTER.kicad_sch]
2022-03-29 add main_holder 3d
    [breakoutboard-sensor_bak.stl, breakoutboard-sensor_bak001.stl]
2022-04-01 add Gesture Control PCBV0.3 Code
    [GestureControl.csv, GestureControl.kicad_pcb]
2022-04-01 add unit test leds
2022-04-08 werking 1 ToF sensor PCBV0.3
    [GestureControl.kicad_pcb]
2022-04-08 werking all ToF interrupt
2022-04-08 Build success low footprint
2022-04-08 I2C not working
2022-04-10 werking all ToF sensors apart
2022-04-11 add not working
    [GestureControl.kicad_pcb]
2022-04-12 add board setup
    [breakoutboard-Body013.stl]
2022-04-12 Add PCBV0.3 3D Parts
    [breakoutboard-Body013.stl, breakoutboard-Body014.stl]
2022-04-14 add juiste layout
    [PCBV0.3-Body.stl, PCBV0.3-Body015.stl, PCBV0.3-Body016.stl]
2022-04-15 add glass cover
    [PCBV0.3-Body.stl, PCBV0.3-Body016.stl, PCBV0.3.FCStd, PCBV0.3.dxf, PCBV0.3_CoverGlas.dxf]
2022-04-19 backup pcb
2022-04-21 1MHz I2C clock
2022-04-22 add all gestures + dxf
    [#GlasPlates-BodySketch.dxf, GlasPlates-BodySketch.dxf, GlasPlates.FCStd]
2022-04-28 add coverglass
    [GlasPlates-Trap.dxf, GlasPlates-Trap_original.dxf, GlasPlates.FCStd]
2022-04-29 begin python csv file
    [GlasPlates-Glasklever.dxf, GlasPlates-Glasklever.stl, GlasPlates.FCStd]
2022-05-02 add better printf
2022-05-03 add smudge onderzoek
    [data_2022-05-03_11528.csv, data_2022-05-03_115742.csv, data_2022-05-03_12031.csv, data_2022-05-03_12115.csv, data_2022-05-03_121326.csv, data_2022-05-03_121713.csv, data_2022-05-03_12211.csv, data_2022-05-03_122416.csv]
2022-05-03 edit schematic
    [GestureControl.kicad_sch]
2022-05-05 i2c1 to 1Mhz
2022-05-06 edit PCB + add docs
    [GestureControl.kicad_pcb, GestureControl.kicad_sch, STM32L151RET6TR.kicad_sch, VL53L3CX_CENTER.kicad_sch]
2022-05-09 add calibrate + sensor exportation
2022-05-09 werking calibrate.h.c
2022-05-09 add final platformIO Project
    [data_2022-05-03_11528.csv, data_2022-05-03_115742.csv, data_2022-05-03_12031.csv, data_2022-05-03_12115.csv, data_2022-05-03_121326.csv, data_2022-05-03_121713.csv, data_2022-05-03_12211.csv, data_2022-05-03_122416.csv]
2022-05-09 add documentatie
    [GlasPlates-Glasklever.stl, GlasPlates-Glasklever_1.4.stl, GlasPlates-Glasklever_1.stl, GlasPlates.FCStd]
2022-05-09 add vl53l5cx upgrades
    [GlasPlates.FCStd]
2022-05-12 add begin data software setup
    [data_2022-05-03_11528.csv, data_2022-05-03_115742.csv, data_2022-05-03_12031.csv, data_2022-05-03_12115.csv, data_2022-05-03_121326.csv, data_2022-05-03_121713.csv, data_2022-05-03_12211.csv, data_2022-05-03_122416.csv]
2022-05-12 add data graphs
    [links_met_duim.csv, links_zonder_duim.csv, rechts_met_duim.csv, rechts_snel_met_duim.csv, rechts_zonder_duim.csv]
2022-05-14 add cad models
    [Gesture Controller-Body.3mf, Gesture Controller.FCStd, Led Controller-Body.3mf, Led Controller.FCStd, nucleo striped.FCStd]
2022-05-16 add 1 sensor debugging
    [data_2022-05-03_11528.csv, data_2022-05-03_115742.csv, data_2022-05-03_12031.csv, data_2022-05-03_12115.csv, data_2022-05-03_121326.csv, data_2022-05-03_121713.csv, data_2022-05-03_12211.csv, data_2022-05-03_122416.csv]
2022-05-16 niet werking led_controller
2022-05-17 add led_controller
2022-05-18 edit scl i2c2
2022-05-19 add extra feedback led controller
2022-05-19 add new calibration + led bug
    [main.c]
2022-05-19 bug brighter led
2022-05-19 led controller refactor
2022-05-20 abstraction led matrix
2022-05-23 add werking led_controller old
2022-05-23 edit docs 9 add puml
    [Led_Controller.kicad_sch]
2022-05-23 add zip led Controller
    [Led_Controller.kicad_sch]
2022-05-24 add oabstract timer + gpio
2022-05-24 add I2C abstraction
2022-05-24 add final map
    [Gesture Controller.FCStd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]
2022-05-24 add final stuff
    [Gesture Controller.FCStd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]
2022-05-26 add fix spiegel + docs
    [main.c]
2022-05-30 documenteren + weird bug
    [main.c]
2022-05-30 fix weird debug + cleanup
    [main.c]
